BlockWorker/EE-BlockBox-v2/Screen/screenBase.png

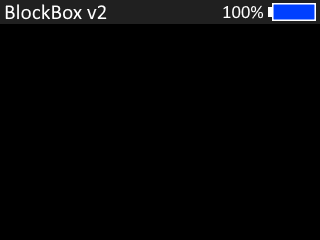
Screen/screenBase.png
