BlockWorker/EE-BlockBox-v2/Screen/screenPowerButton.png

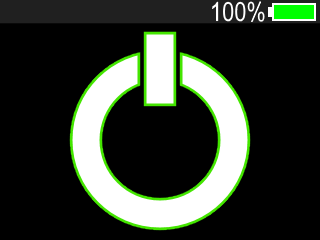
Screen/screenPowerButton.png
