BlockWorker/EE-BlockBox-v2/(list of files, cad)

Other CAD files:
Fusion360/Main v23.f3z
