BlockWorker/EE-BlockBox-v2/BlockBox v2.brd

## EAGLE design BlockBox v2.brd (2020-03-26)

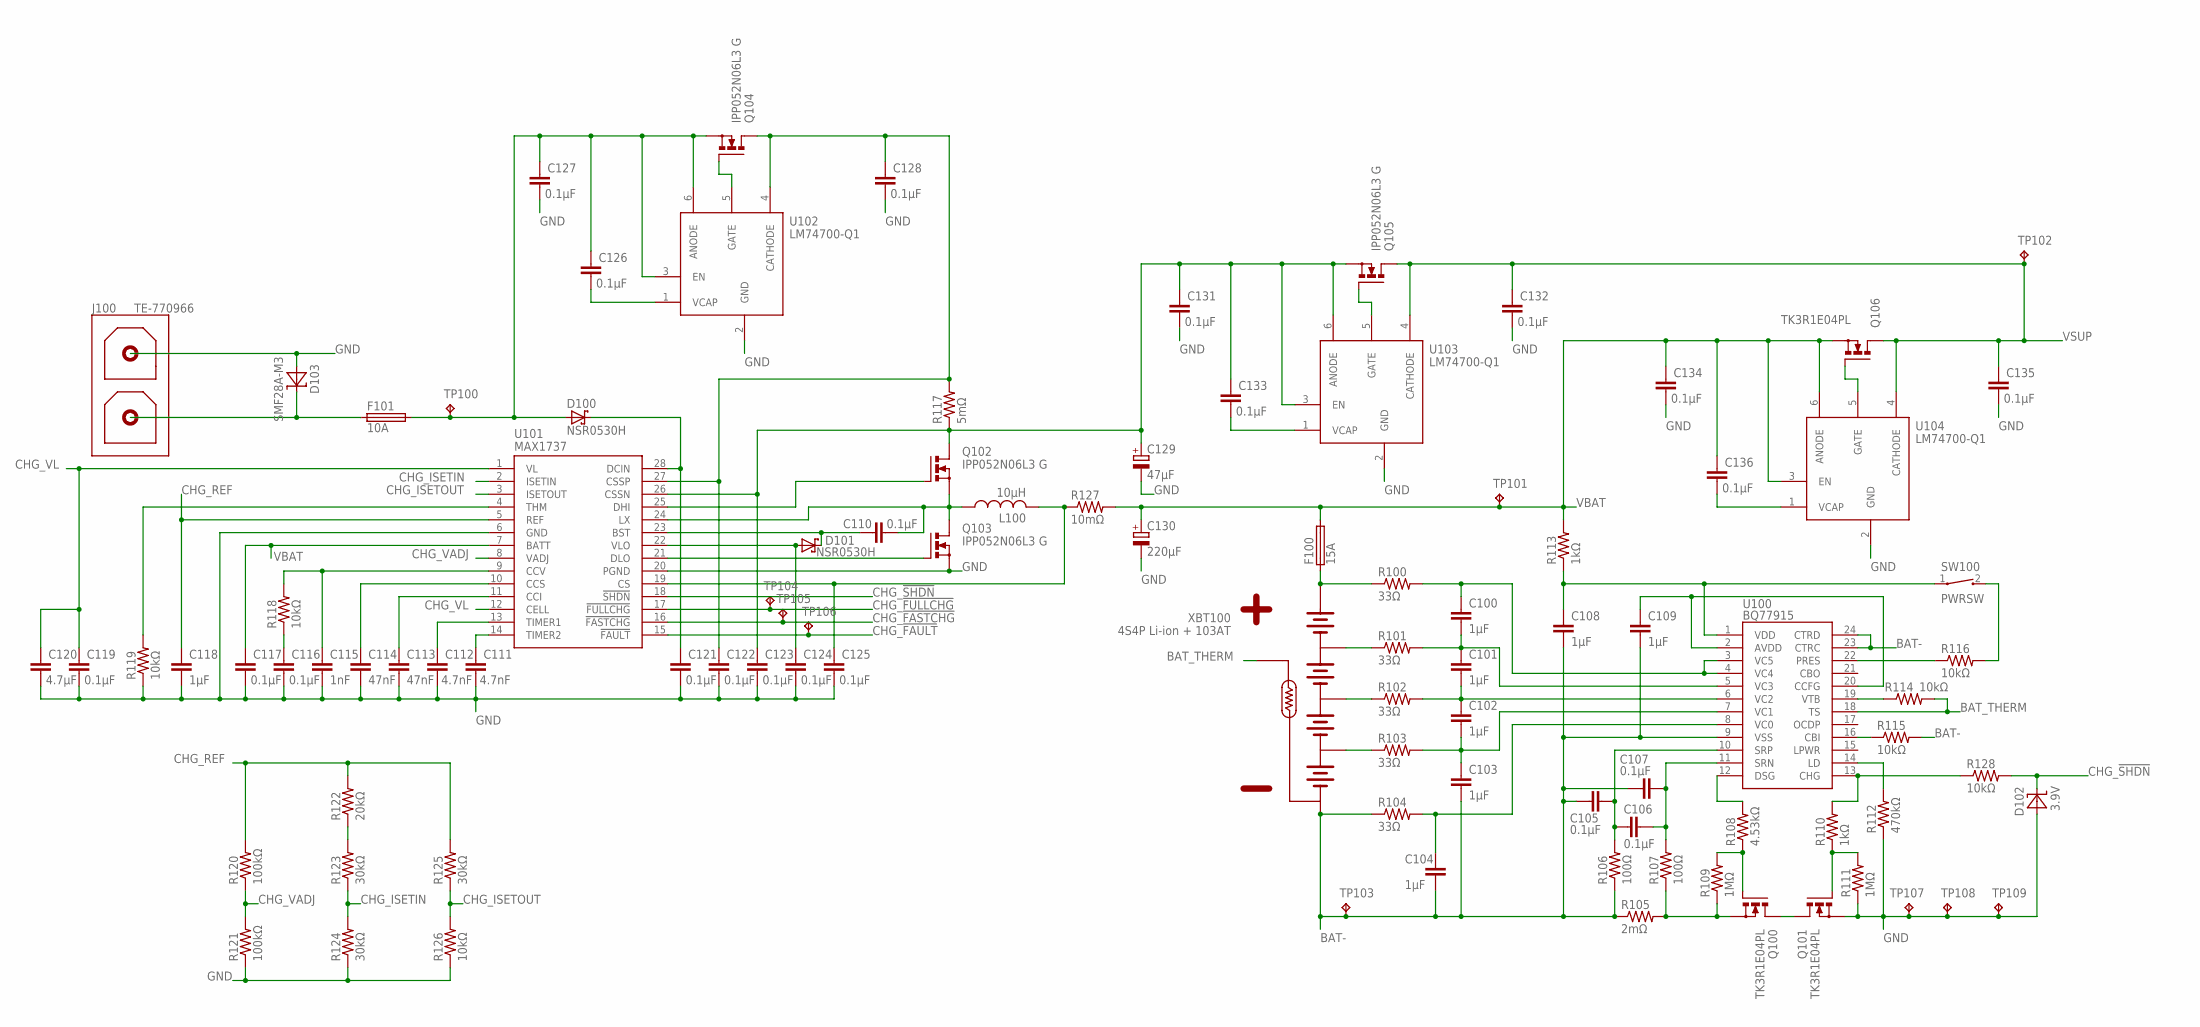
[picture p3: schematic BlockBox v2.sch, sheet 1, Battery]

Parts:
C100, C101, C102, C103, C104, C108, C109, C118: 1µF; C0603
C105, C106, C107, C110, C116, C117, C119, C121, C122, C123, C124, C125, C126, C127, C128, C131, C132, C133, C134, C135, C136: 0.1µF; C0603
C111, C112: 4.7nF; C0603
C113, C114: 47nF; C0603
C115: 1nF; C0603
C120: 4.7µF; C0805
C129: 47µF; E2,5-6
C130: 220µF; E3,5-8
D100, D101: NSR0530H; SOD323
D102: 3.9V; SOD323
D103: SMF28A-M3; DO-219AB
F100: 15A; F2410
F101: 10A; F2410
J100: TE-770966
L100: 10µH; PM5022
Q100, Q101, Q106: TK3R1E04PL; TO220BV-HS1
Q102, Q103, Q104, Q105: IPP052N06L3 G; TO220BV-HS1
R100, R101, R102, R103, R104: 33Ω; R0603
R105: 2mΩ; R2512
R106, R107: 100Ω; R0603
R108: 4.53kΩ; R0603
R109, R111: 1MΩ; R0603
R110, R113: 1kΩ; R0603
R112: 470kΩ; R0603
R114, R115, R116, R118, R119, R126, R128: 10kΩ; R0603
R117: 5mΩ; R1206
R120, R121: 100kΩ; R0603
R122: 20kΩ; R0603
R123, R124, R125: 30kΩ; R0603
R127: 10mΩ; R1206
SW100: PWRSW; WIRE-2P-SIMPLE
TP100, TP101, TP102, TP103, TP104, TP105, TP106, TP107, TP108, TP109: TPTP15R; TP15R
U100: BQ77915; TSSOP24
U101: MAX1737; QSOP28
U102, U103, U104: LM74700-Q1; SOT23-6L
XBT100: 4S4P Li-ion + 103AT; TE-770970

Connections:
BAT-: C103.2, C104.2, C105.1, C107.1, C108.2, C109.2, R104.1, R105.1, R106.1, R115.2, TP103.TP, U100.9 (VSS), U100.23 (CTRC), U100.24 (CTRD), XBT100.5 (-), XBT100.6 (-); also elsewhere on the board
BAT-_INT1: Q100.S, R105.2, R107.1, R109.1
BAT-_INT2: Q100.D, Q101.D
BAT_AVDD: C109.1, U100.2 (AVDD), U100.20 (CCFG)
BAT_BAL0: C104.1, R104.2, U100.8 (VC0)
BAT_BAL1: C102.2, C103.1, R103.2, U100.7 (VC1)
BAT_BAL2: C101.2, C102.1, R102.2, U100.6 (VC2)
BAT_BAL3: C100.2, C101.1, R101.2, U100.5 (VC3)
BAT_BAL4: C100.1, R100.2, U100.3 (VC5), U100.4 (VC4)
BAT_CBI: R115.1, U100.16 (CBI)
BAT_CHG_CTL: R110.2, R128.1, U100.13 (CHG)
BAT_CHG_GATE: Q101.G, R110.1, R111.2
BAT_CSN: C106.2, C107.2, R107.2, U100.11 (SRN); also elsewhere on the board
BAT_CSP: C105.2, C106.1, R106.2, U100.10 (SRP); also elsewhere on the board
BAT_DSG_CTL: R108.2, U100.12 (DSG)
BAT_DSG_GATE: Q100.G, R108.1, R109.2
BAT_INT1: R103.1, XBT100.4 (BAL1)
BAT_INT2: R102.1, XBT100.3 (BAL2)
BAT_INT3: R101.1, XBT100.7 (BAL3)
BAT_LD: R112.2, U100.14 (LD)
BAT_PRES: R116.1, U100.22 (PRES)
BAT_PRES_SW: R116.2, SW100.2
BAT_THERM: R114.2, U100.18 (TS), XBT100.8 (THERM1)
BAT_VDD: C108.1, R113.1, SW100.1, U100.1 (VDD)
BAT_VTB: R114.1, U100.19 (VTB)
CHG_!FASTCHG: TP105.TP, U101.16 (!FASTCHG); also elsewhere on the board
CHG_!FAULT: TP106.TP, U101.15 (!FAULT); also elsewhere on the board
CHG_!FULLCHG: TP104.TP, U101.17 (!FULLCHG); also elsewhere on the board
CHG_!SHDN: D102.1 (C), R128.2, U101.18 (!SHDN)
CHG_BST: C110.1, D101.1 (C), U101.23 (BST)
CHG_CCI: C113.1, U101.11 (CCI)
CHG_CCS: C114.1, U101.10 (CCS)
CHG_CCV: C115.1, R118.2, U101.9 (CCV)
CHG_CCV_FILT: C116.1, R118.1
CHG_CS: C125.1, L100.2, R127.1, U101.19 (CS)
CHG_CSSN: C123.1, C129.+, C131.1, C133.1, Q102.D, Q105.S, R117.1, U101.26 (CSSN), U103.3 (EN), U103.6 (ANODE)
CHG_CSSP: C122.1, C128.1, Q104.D, R117.2, U101.27 (CSSP), U102.4 (CATHODE)
CHG_DCIN: C121.1, D100.1 (C), U101.28 (DCIN)
CHG_DHI: Q102.G, U101.25 (DHI)
CHG_DLO: Q103.G, U101.21 (DLO)
CHG_ISETIN: R123.1, R124.2, U101.2 (ISETIN)
CHG_ISETIN_INT: R122.1, R123.2
CHG_ISETOUT: R125.1, R126.2, U101.3 (ISETOUT)
CHG_LX: C110.2, L100.1, Q102.S, Q103.D, U101.24 (LX)
CHG_REF: C118.1, R120.2, R122.2, R125.2, U101.5 (REF)
CHG_THM: R119.2, U101.4 (THM)
CHG_TIMER1: C112.1, U101.13 (TIMER1)
CHG_TIMER2: C111.1, U101.14 (TIMER2)
CHG_VADJ: R120.1, R121.2, U101.8 (VADJ)
CHG_VL: C119.1, C120.1, U101.1 (VL), U101.12 (CELL)
CHG_VLO: C124.1, D101.2 (A), U101.22 (VLO)
GND: C111.2, C112.2, C113.2, C114.2, C115.2, C116.2, C117.2, C118.2, C119.2, C120.2, C121.2, C122.2, C123.2, C124.2, C125.2, C127.2, C128.2, C129.-, C130.-, C131.2, C132.2, C134.2, C135.2, D102.2 (A), D103.A, J100.2, Q101.S, Q103.S, R111.1, R112.1, R119.1, R121.1, R124.1, R126.1, TP107.TP, TP108.TP, TP109.TP, U101.6 (GND), U101.20 (PGND), U102.2 (GND), U103.2 (GND), U104.2 (GND); also elsewhere on the board
VBAT: C117.1, C130.+, C134.1, C136.1, F100.2, Q106.S, R113.2, R127.2, TP101.TP, U101.7 (BATT), U104.3 (EN), U104.6 (ANODE); also elsewhere on the board
VBAT_PREFUSE: F100.1, R100.1, XBT100.1 (+), XBT100.2 (+)
VIN_EXT: D103.K (C), F101.1, J100.1
VIN_EXT_FUSED: C126.1, C127.1, D100.2 (A), F101.2, Q104.S, TP100.TP, U102.3 (EN), U102.6 (ANODE)
VIN_ID_GATE: Q104.G, U102.5 (GATE)
VIN_ID_VCAP: C126.2, U102.1 (VCAP)
VSUP: C132.1, C135.1, Q105.D, Q106.D, TP102.TP, U103.4 (CATHODE), U104.4 (CATHODE); also elsewhere on the board
VSUP_ID1_GATE: Q105.G, U103.5 (GATE)
VSUP_ID1_VCAP: C133.2, U103.1 (VCAP)
VSUP_ID2_GATE: Q106.G, U104.5 (GATE)
VSUP_ID2_VCAP: C136.2, U104.1 (VCAP)

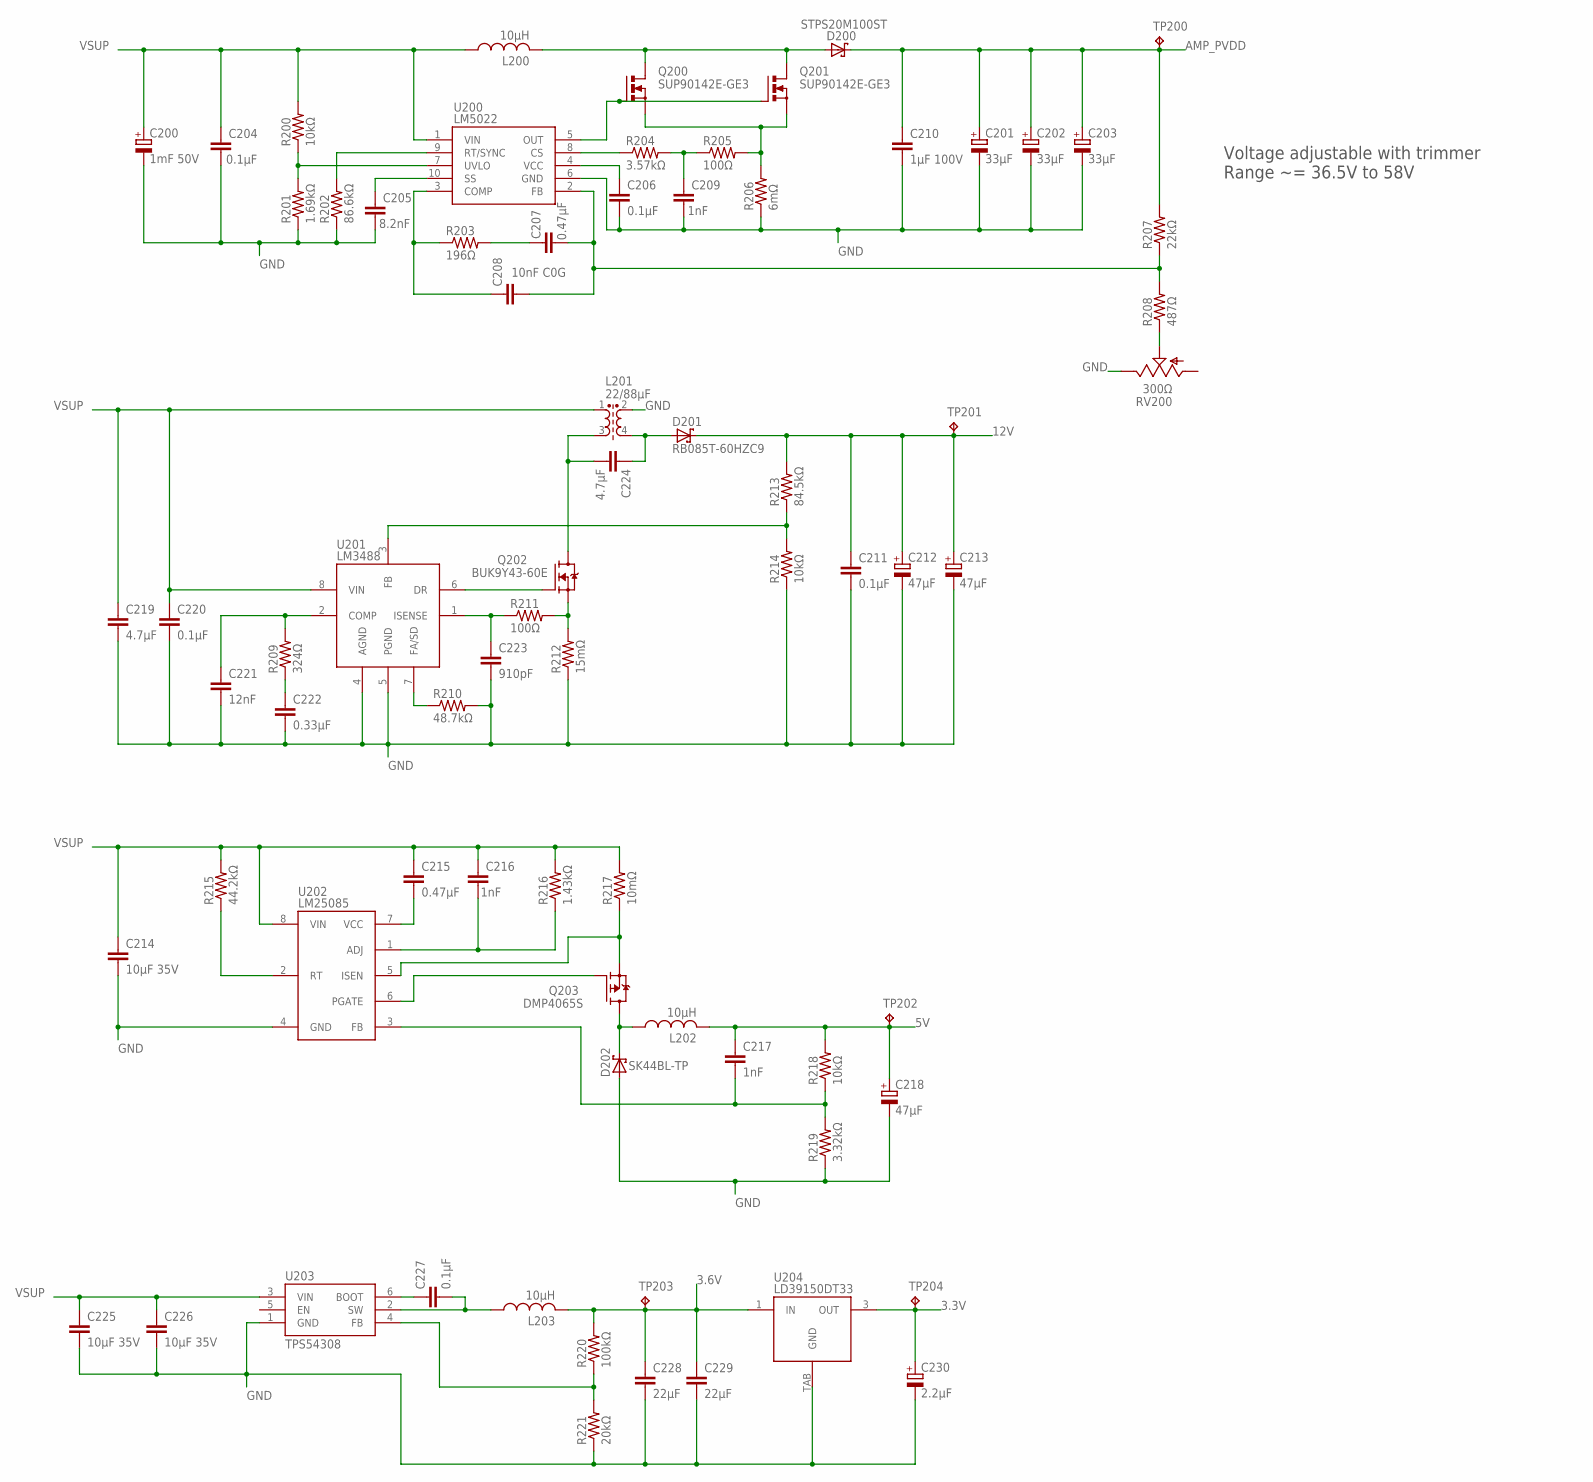
[picture p4: schematic BlockBox v2.sch, sheet 2, Power conversion]

Parts:
C200: 1mF 50V; E7,5-16
C201, C202, C203: 33µF; E3,5-8
C204, C206, C211, C220, C227: 0.1µF; C0603
C205: 8.2nF; C0603
C207: 0.47µF; C050-035X075
C208: 10nF C0G; C0603
C209, C216, C217: 1nF; C0603
C210: 1µF 100V; C1206
C212, C213, C218: 47µF; E2,5-6
C214, C225, C226: 10µF 35V; C1206
C215: 0.47µF; C0603
C219, C224: 4.7µF; C0805
C221: 12nF; C0603
C222: 0.33µF; C050-035X075
C223: 910pF; C0603
C228, C229: 22µF; C0805
C230: 2.2µF; PANASONIC_B
D200: STPS20M100ST; TO220ABS-HS1
D201: RB085T-60HZC9; TO220ABS-HS1
D202: SK44BL-TP; DO-214AA
L200: 10µH; PQ2614B
L201: 22/88µF; SRF1280A
L202: 10µH; SRN1060
L203: 10µH; RLB0912
Q200, Q201: SUP90142E-GE3; TO220BV-HS1
Q202: BUK9Y43-60E; SOT669
Q203: DMP4065S; SOT23
R200, R214, R218: 10kΩ; R0603
R201: 1.69kΩ; R0603
R202: 86.6kΩ; R0603
R203: 196Ω; R0603
R204: 3.57kΩ; R0603
R205, R211: 100Ω; R0603
R206: 6mΩ; R2512
R207: 22kΩ; R0603
R208: 487Ω; R0603
R209: 324Ω; R0603
R210: 48.7kΩ; R0603
R212: 15mΩ; R0612
R213: 84.5kΩ; R0603
R215: 44.2kΩ; R0603
R216: 1.43kΩ; R0603
R217: 10mΩ; R1206
R219: 3.32kΩ; R0603
R220: 100kΩ; R0603
R221: 20kΩ; R0603
RV200: 300Ω; TC33X-2
TP200, TP201, TP202, TP203, TP204: TPTP15R; TP15R
U200: LM5022; VSSOP10
U201: LM3488; VSSOP8
U202: LM25085; VSSOP8
U203: TPS54308; SOT23-6L
U204: LD39150DT33; DPAK

Connections:
3.3V: C230.+, TP204.TP, U204.3 (OUT); also elsewhere on the board
3.6V: C228.1, C229.1, L203.2, R220.2, TP203.TP, U204.1 (IN)
5V: C217.1, C218.+, L202.2, R218.2, TP202.TP; also elsewhere on the board
12V: C211.1, C212.+, C213.+, D201.C, R213.2, TP201.TP; also elsewhere on the board
AMP_PVDD: C201.+, C202.+, C203.+, C210.1, D200.C, R207.2, TP200.TP; also elsewhere on the board
BOOST_COMP: C208.1, R203.1, U200.3 (COMP)
BOOST_COMP_INT: C207.1, R203.2
BOOST_CS: R204.1, U200.8 (CS)
BOOST_CS_FILTER: C209.1, R204.2, R205.1
BOOST_FB: C207.2, C208.2, R207.1, R208.2, U200.2 (FB)
BOOST_FB_ADJ: R208.1, RV200.2 (S)
BOOST_RT: R202.2, U200.9 (RT/SYNC)
BOOST_SS: C205.1, U200.10 (SS)
BOOST_SW_DRAIN: D200.A1 (A), D200.A2 (A), L200.2, Q200.D, Q201.D
BOOST_SW_GATE: Q200.G, Q201.G, U200.5 (OUT)
BOOST_SW_SOURCE: Q200.S, Q201.S, R205.2, R206.2
BOOST_UVLO: R200.1, R201.2, U200.7 (UVLO)
BOOST_VCC: C206.1, U200.4 (VCC)
BUCK_ADJ: C216.2, R216.1, U202.1 (ADJ)
BUCK_FB: C217.2, R218.1, R219.2, U202.3 (FB)
BUCK_RT: R215.1, U202.2 (RT)
BUCK_SW_DRAIN: Q203.2 (S), R217.1, U202.5 (ISEN)
BUCK_SW_GATE: Q203.1 (G), U202.6 (PGATE)
BUCK_SW_SOURCE: D202.K (C), L202.1, Q203.3 (D)
BUCK_VCC: C215.2, U202.7 (VCC)
GND: C200.-, C201.-, C202.-, C203.-, C204.2, C205.2, C206.2, C209.2, C210.2, C211.2, C212.-, C213.-, C214.2, C218.-, C219.2, C220.2, C221.2, C222.2, C223.2, C225.2, C226.2, C228.2, C229.2, C230.-, D202.A, L201.2 (S1), R201.1, R202.1, R206.1, R210.2, R212.1, R214.1, R219.1, R221.1, RV200.3 (E), U200.6 (GND), U201.4 (AGND), U201.5 (PGND), U202.4 (GND), U203.1 (GND), U204.TAB (GND); also elsewhere on the board
PRELIN_BOOT: C227.1, U203.6 (BOOT)
PRELIN_FB: R220.1, R221.2, U203.4 (FB)
PRELIN_SW: C227.2, L203.1, U203.2 (SW)
SEPIC_COMP: C221.1, R209.2, U201.2 (COMP)
SEPIC_COMP_INT: C222.1, R209.1
SEPIC_FA: R210.1, U201.7 (FA/SD)
SEPIC_FB: R213.1, R214.2, U201.3 (FB)
SEPIC_ISENSE: C223.1, R211.1, U201.1 (ISENSE)
SEPIC_PREDIODE: C224.1, D201.A1 (A), D201.A2 (A), L201.4 (S2)
SEPIC_SW_DRAIN: C224.2, L201.3 (P2), Q202.MB (D)
SEPIC_SW_GATE: Q202.4 (G), U201.6 (DR)
SEPIC_SW_SOURCE: Q202.1 (S), Q202.2 (S), Q202.3 (S), R211.2, R212.2
VSUP: C200.+, C204.1, C214.1, C215.1, C216.1, C219.1, C220.1, C225.1, C226.1, L200.1, L201.1, R200.2, R215.2, R216.2, R217.2, U200.1 (VIN), U201.8 (VIN), U202.8 (VIN), U203.3 (VIN); also elsewhere on the board

Notes on the sheet:
Voltage adjustable with trimmer Range ~= 36.5V to 58V

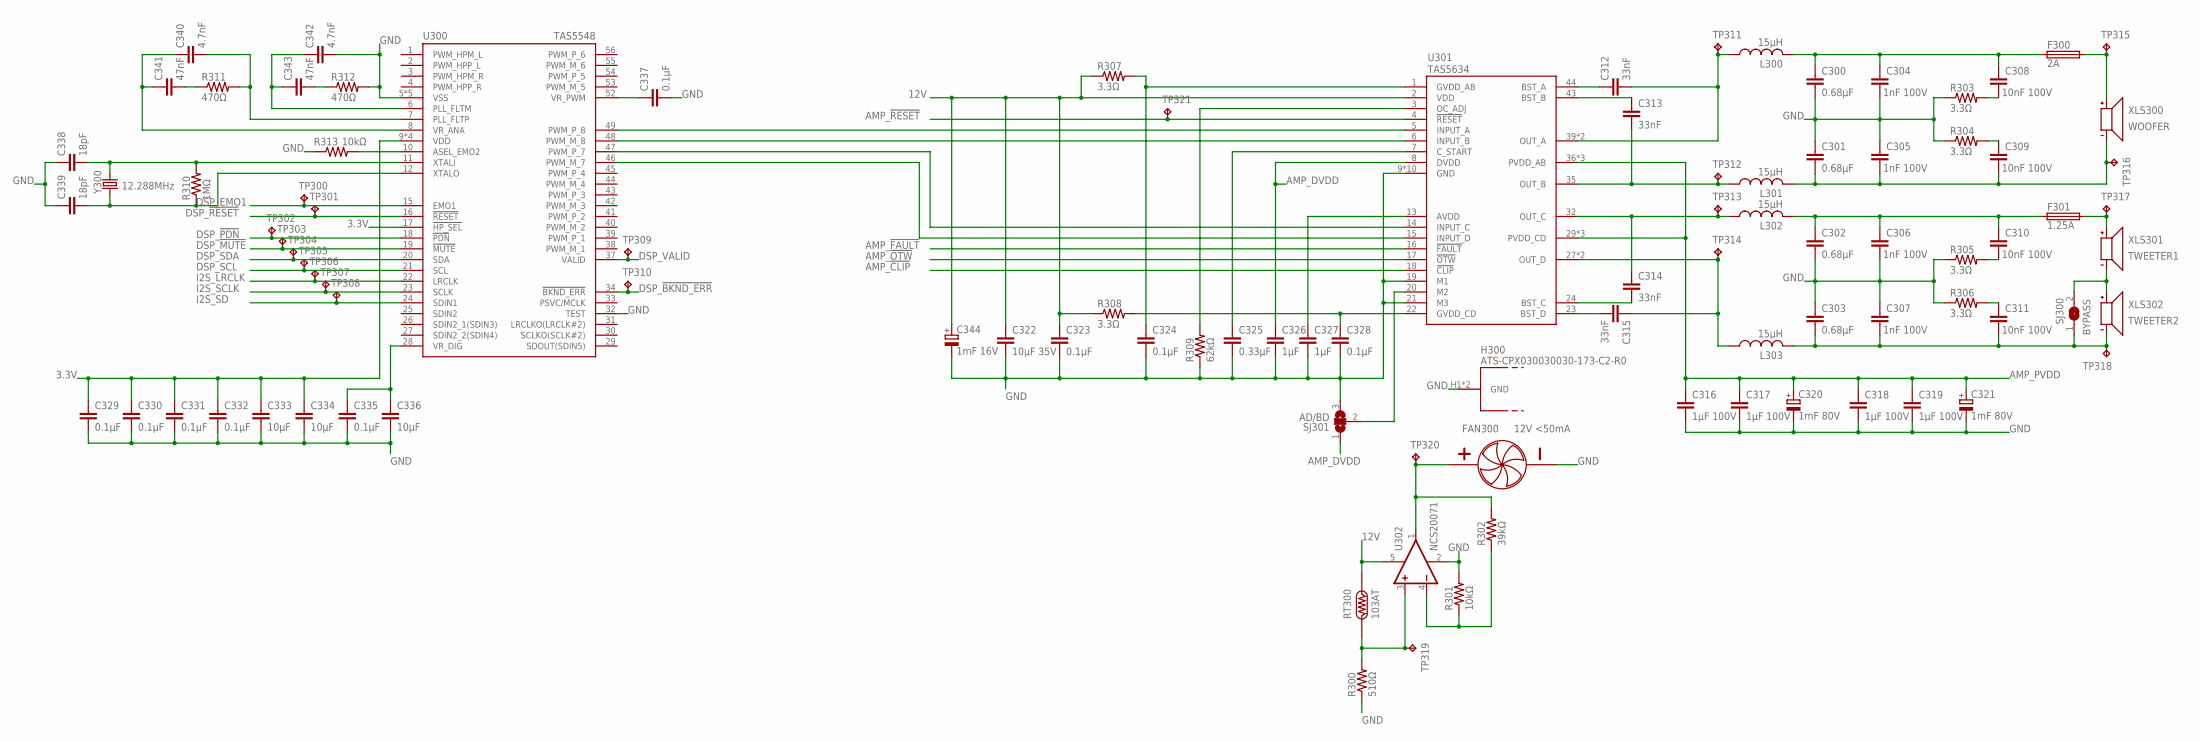
[picture p5: schematic BlockBox v2.sch, sheet 3, Audio path]

Parts:
C300, C301, C302, C303: 0.68µF; C150-064X183
C304, C305, C306, C307: 1nF 100V; C0603
C308, C309, C310, C311: 10nF 100V; C0603
C312, C313, C314, C315: 33nF; C0805
C316, C317, C318, C319: 1µF 100V; C1206
C320, C321: 1mF 80V; E7,5-16
C322: 10µF 35V; C1206
C323, C324, C328, C329, C330, C331, C332, C335, C337: 0.1µF; C0603
C325: 0.33µF; C0603
C326, C327: 1µF; C0603
C333, C334, C336: 10µF; C0805
C338, C339: 18pF; C0603
C340, C342: 4.7nF; C0603
C341, C343: 47nF; C0603
C344: 1mF 16V; E5-10,5
F300: 2A; MRF_FUSE
F301: 1.25A; MRF_FUSE
FAN300: 12V <50mA; WIRE-2P-SIMPLE
H300: ATS-CPX030030030-173-C2-R0
L300, L301, L302, L303: 15µH; 1D14A
R300: 510Ω; R0603
R301, R313: 10kΩ; R0603
R302: 39kΩ; R0603
R303, R304, R305, R306, R307, R308: 3.3Ω; R0805
R309: 62kΩ; R0603
R310: 1MΩ; R0603
R311, R312: 470Ω; R0603
RT300: 103AT; WIRE-2P-SIMPLE
SJ300: BYPASS; SJ
SJ301: AD/BD; SJ_2
TP300, TP301, TP302, TP303, TP304, TP305, TP306, TP307, TP308, TP309, TP310, TP311, TP312, TP313, TP314, TP315, TP316, TP317, TP318, TP319, TP320, TP321: TPTP15R; TP15R
U300: TAS5548; HTSSOP56DCA
U301: TAS5634; TSSOP44
U302: NCS20071; TSOP-5
XLS300: WOOFER; TE-770966
XLS301: TWEETER1; TE-770966
XLS302: TWEETER2; TE-770966
Y300: 12.288MHz; HC49US

Connections:
3.3V: C329.1, C330.1, C331.1, C332.1, C333.1, C334.1, U300.9 (VDD), U300.14 (VDD), U300.17 (!HP_SEL), U300.35 (VDD), U300.50 (VDD); also elsewhere on the board
12V: C322.1, C323.1, C344.+, R307.1, R308.1, RT300.1, U301.2 (VDD), U302.5 (V+); also elsewhere on the board
AMP_!CLIP: U301.18 (!CLIP); also elsewhere on the board
AMP_!FAULT: U301.16 (!FAULT); also elsewhere on the board
AMP_!OTW: U301.17 (!OTW); also elsewhere on the board
AMP_!RESET: TP321.TP, U301.4 (!RESET); also elsewhere on the board
AMP_AVDD: C327.1, U301.13 (AVDD)
AMP_A_FILT: C300.1, C304.1, C308.1, F300.1, L300.2
AMP_A_FILT_INT: C308.2, R303.2
AMP_A_FUSED: F300.2, TP315.TP, XLS300.2 (+)
AMP_BST_A: C312.1, U301.44 (BST_A)
AMP_BST_B: C313.1, U301.43 (BST_B)
AMP_BST_C: C314.2, U301.24 (BST_C)
AMP_BST_D: C315.2, U301.23 (BST_D)
AMP_B_FILT: C301.1, C305.2, C309.2, L301.2, TP316.TP, XLS300.1 (-)
AMP_B_FILT_INT: C309.1, R304.2
AMP_CD_MID: SJ300.2, XLS301.1 (-), XLS302.2 (+)
AMP_C_FILT: C302.1, C306.1, C310.1, F301.1, L302.2
AMP_C_FILT_INT: C310.2, R305.2
AMP_C_FUSED: F301.2, TP317.TP, XLS301.2 (+)
AMP_C_START: C325.1, U301.7 (C_START)
AMP_DVDD: C326.1, SJ301.1, U301.8 (DVDD)
AMP_D_FILT: C303.1, C307.2, C311.2, L303.2, SJ300.1, TP318.TP, XLS302.1 (-)
AMP_D_FILT_INT: C311.1, R306.2
AMP_FAN_+: FAN300.1 (+), R302.2, TP320.TP, U302.1 (OUT)
AMP_FAN_FB: R301.1, R302.1, U302.4 (-IN)
AMP_FAN_SENSE: R300.2, RT300.2, TP319.TP, U302.3 (+IN)
AMP_GVDD_AB: C324.1, R307.2, U301.1 (GVDD_AB)
AMP_GVDD_CD: C328.1, R308.2, U301.22 (GVDD_CD)
AMP_INPUT_A: U300.49 (PWM_P_8), U301.5 (INPUT_A)
AMP_INPUT_B: U300.48 (PWM_M_8), U301.6 (INPUT_B)
AMP_INPUT_C: U300.47 (PWM_P_7), U301.14 (INPUT_C)
AMP_INPUT_D: U300.46 (PWM_M_7), U301.15 (INPUT_D)
AMP_M2: SJ301.2, U301.20 (M2)
AMP_OC_ADJ: R309.2, U301.3 (OC_ADJ)
AMP_OUT_A: C312.2, L300.1, TP311.TP, U301.39 (OUT_A), U301.40 (OUT_A)
AMP_OUT_B: C313.2, L301.1, TP312.TP, U301.35 (OUT_B)
AMP_OUT_C: C314.1, L302.1, TP313.TP, U301.32 (OUT_C)
AMP_OUT_D: C315.1, L303.1, TP314.TP, U301.27 (OUT_D), U301.28 (OUT_D)
AMP_PVDD: C316.1, C317.1, C318.1, C319.1, C320.+, C321.+, U301.29 (PVDD_CD), U301.30 (PVDD_CD), U301.31 (PVDD_CD), U301.36 (PVDD_AB), U301.37 (PVDD_AB), U301.38 (PVDD_AB); also elsewhere on the board
DSP_!BKND_ERR: TP310.TP, U300.34 (!BKND_ERR); also elsewhere on the board
DSP_!MUTE: TP303.TP, U300.19 (!MUTE); also elsewhere on the board
DSP_!PDN: TP302.TP, U300.18 (!PDN); also elsewhere on the board
DSP_!RESET: TP301.TP, U300.16 (!RESET); also elsewhere on the board
DSP_ASEL_EMO2: R313.2, U300.10 (ASEL_EMO2)
DSP_EMO1: TP300.TP, U300.15 (EMO1); also elsewhere on the board
DSP_PLL_FLTM: C342.1, C343.1, U300.6 (PLL_FLTM)
DSP_PLL_FLTP: C340.2, R311.2, U300.7 (PLL_FLTP)
DSP_PLL_FLTP_INT: C341.2, R311.1
DSP_PLL_FPLM_INT: C343.2, R312.1
DSP_SCL: TP305.TP, U300.21 (SCL); also elsewhere on the board
DSP_SDA: TP304.TP, U300.20 (SDA); also elsewhere on the board
DSP_VALID: TP309.TP, U300.37 (VALID); also elsewhere on the board
DSP_VR_ANA: C340.1, C341.1, U300.8 (VR_ANA)
DSP_VR_DIG: C335.1, C336.1, U300.28 (VR_DIG)
DSP_VR_PWM: C337.1, U300.52 (VR_PWM)
DSP_XTALI: C338.2, R310.2, U300.11 (XTALI), Y300.2
DSP_XTALO: C339.2, R310.1, U300.12 (XTALO), Y300.1
GND: C300.2, C301.2, C302.2, C303.2, C304.2, C305.1, C306.2, C307.1, C316.2, C317.2, C318.2, C319.2, C320.-, C321.-, C322.2, C323.2, C324.2, C325.2, C326.2, C327.2, C328.2, C329.2, C330.2, C331.2, C332.2, C333.2, C334.2, C335.2, C336.2, C337.2, C338.1, C339.1, C342.2, C344.-, FAN300.2 (-), H300.H1, H300.H2, R300.1, R301.2, R303.1, R304.1, R305.1, R306.1, R309.1, R312.2, R313.1, SJ301.3, U300.5 (VSS), U300.13 (VSS), U300.32 (TEST), U300.36 (VSS), U300.51 (VSS), U300.EXP (VSS), U301.9 (GND), U301.10 (GND), U301.11 (GND), U301.12 (GND), U301.19 (M1), U301.21 (M3), U301.25 (GND), U301.26 (GND), U301.33 (GND), U301.34 (GND), U301.41 (GND), U301.42 (GND), U302.2 (V-); also elsewhere on the board
I2S_LRCLK: TP306.TP, U300.22 (LRCLK); also elsewhere on the board
I2S_SCLK: TP307.TP, U300.23 (SCLK); also elsewhere on the board
I2S_SD: TP308.TP, U300.24 (SDIN1); also elsewhere on the board

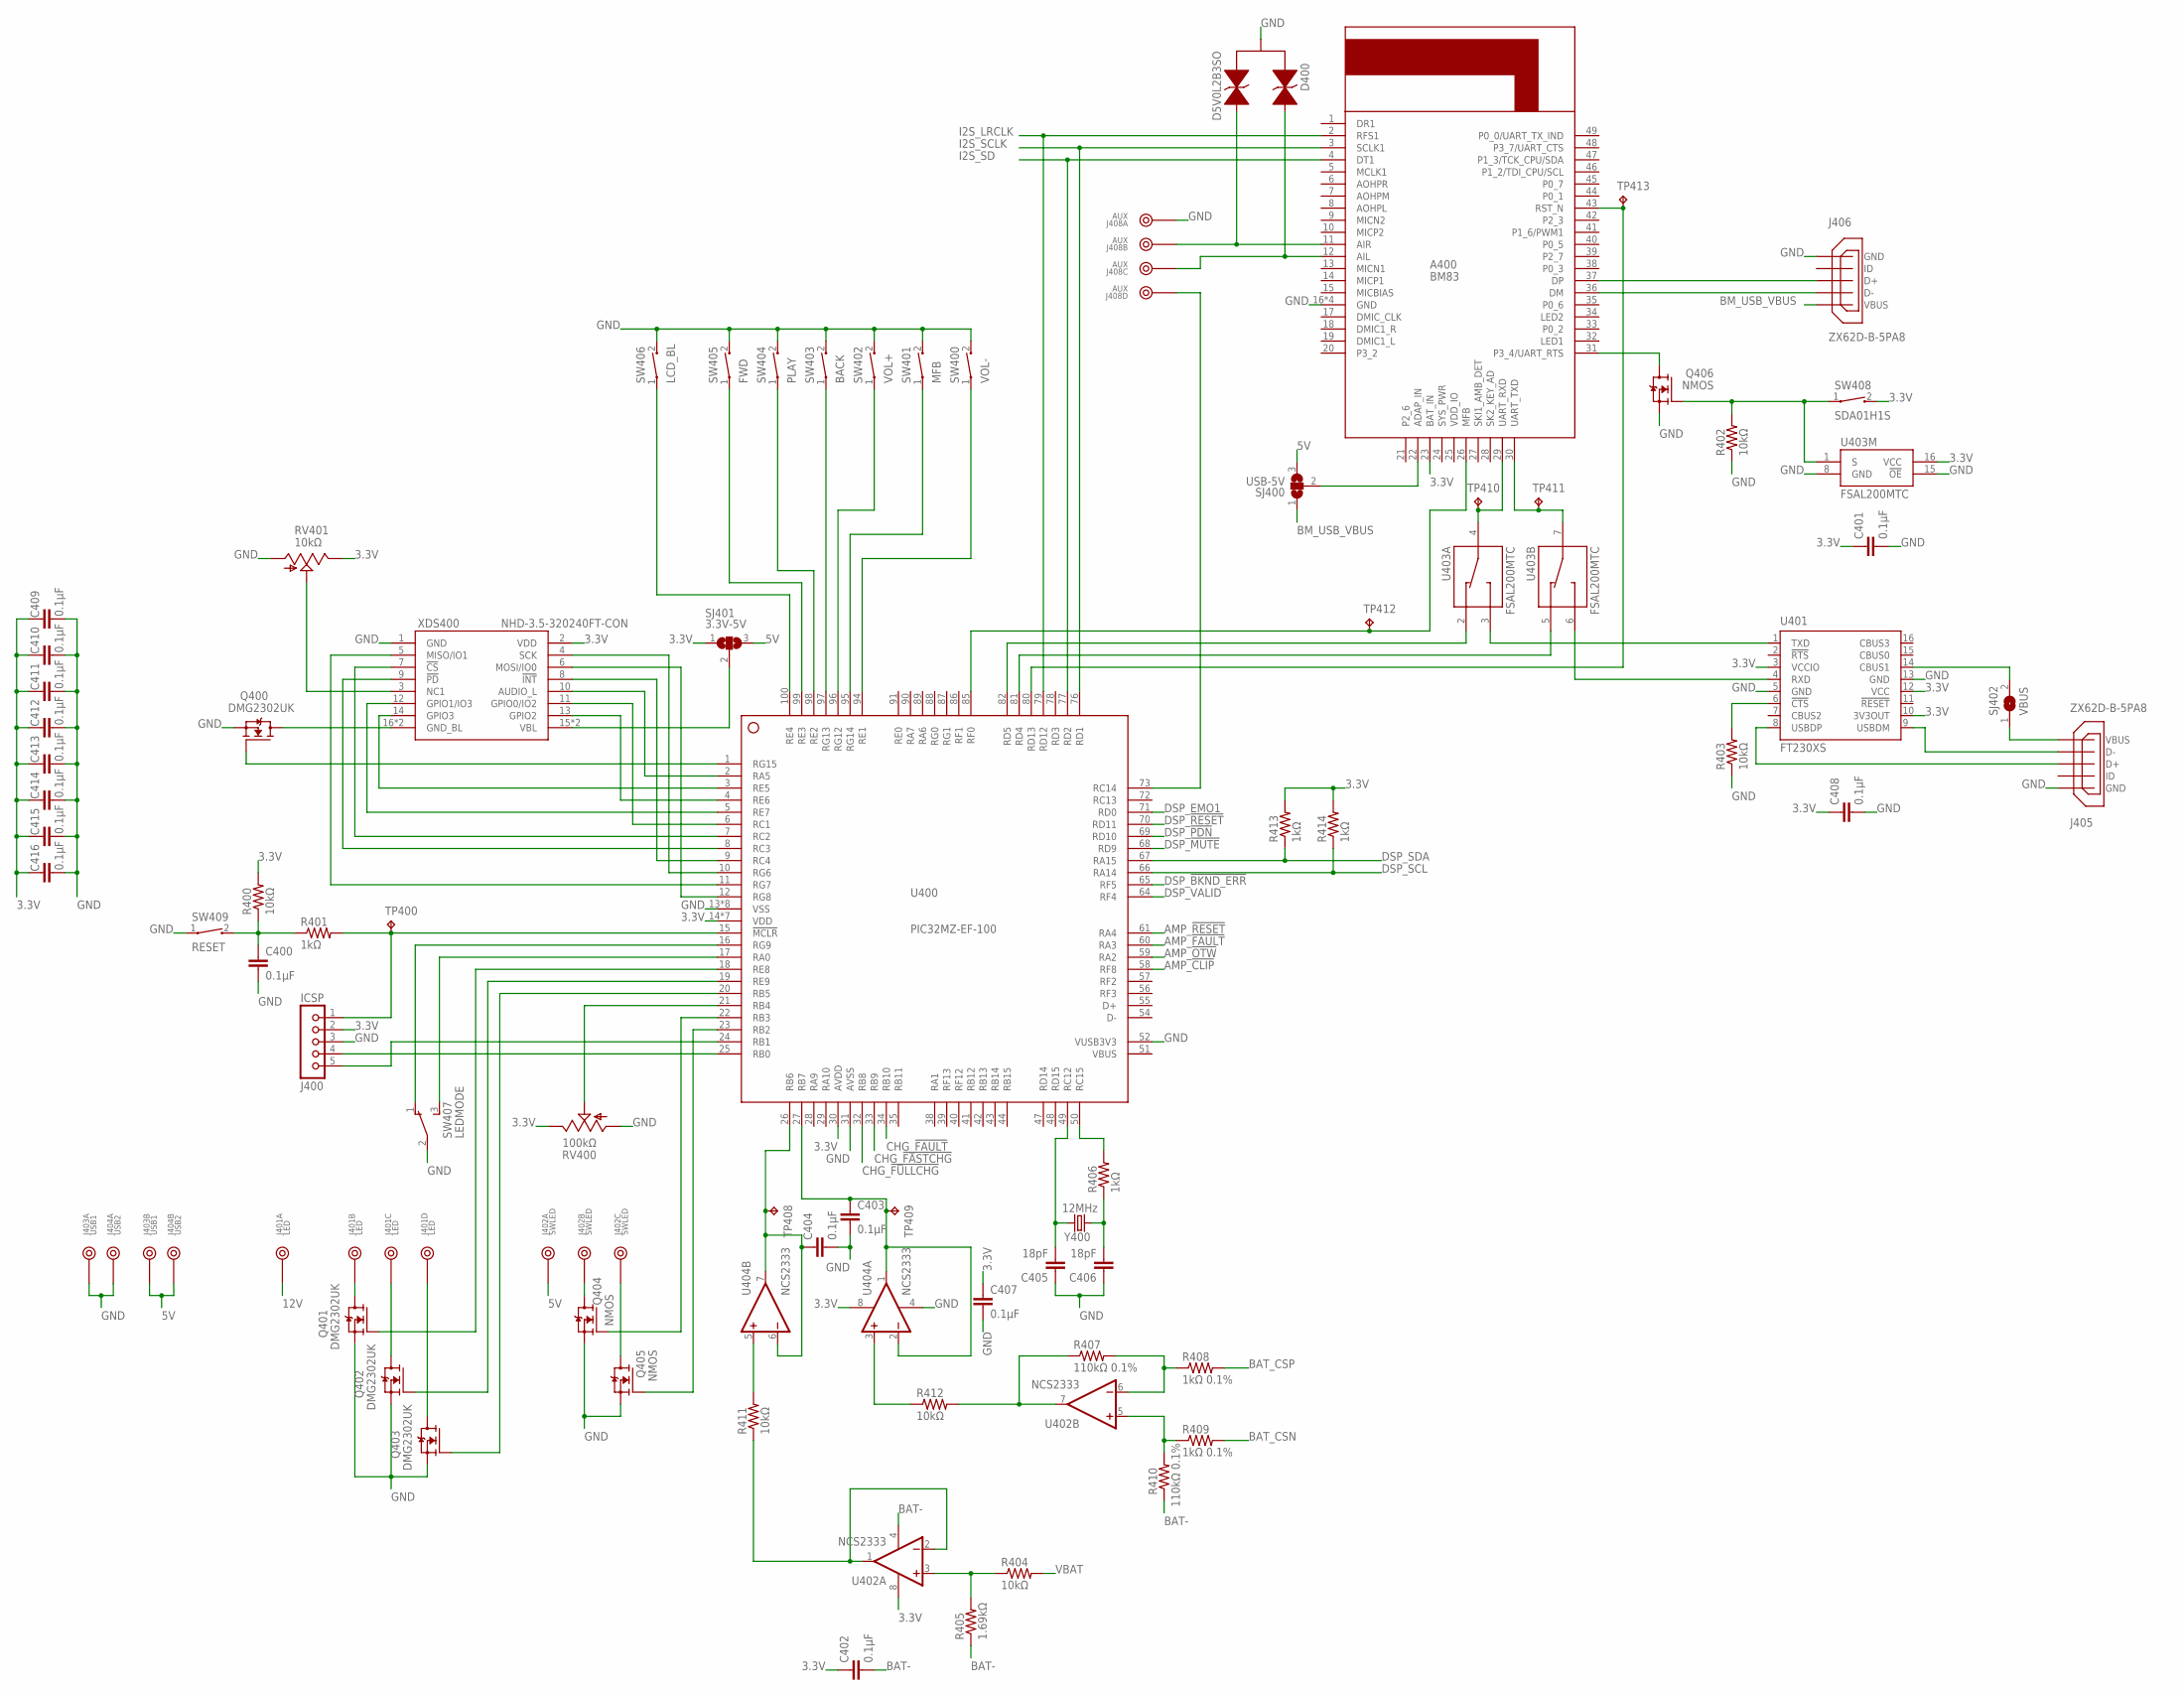
[picture p6: schematic BlockBox v2.sch, sheet 4, Control]

Parts:
A400: BM83
C400, C401, C402, C403, C404, C407, C408, C409, C410, C411, C412, C413, C414, C415, C416: 0.1µF; C0603
C405, C406: 18pF; C0603
D400: D5V0L2B3SO; SOT23
J400: ICSP; 5P-1.27-POGO
J401: LED; 4PIN
J402: SWLED; 3PIN
J403: USB1; 2PIN
J404: USB2; 2PIN
J405, J406: ZX62D-B-5PA8
J408: AUX; 4PIN
Q400, Q401, Q402, Q403: DMG2302UK; SOT23
Q404, Q405, Q406: NMOS; SOT23
R400, R402, R403, R404, R411, R412: 10kΩ; R0603
R401, R406, R413, R414: 1kΩ; R0603
R405: 1.69kΩ; R0603
R407, R410: 110kΩ 0.1%; R0603
R408, R409: 1kΩ 0.1%; R0603
RV400: 100kΩ; WIRE-3P-SIMPLE
RV401: 10kΩ; TC33X-2
SJ400: USB-5V; SJ_2
SJ401: 3.3V-5V; SJ_2
SJ402: VBUS; SJ
SW400: VOL-; WIRE-2P-SIMPLE
SW401: MFB; WIRE-2P-SIMPLE
SW402: VOL+; WIRE-2P-SIMPLE
SW403: BACK; WIRE-2P-SIMPLE
SW404: PLAY; WIRE-2P-SIMPLE
SW405: FWD; WIRE-2P-SIMPLE
SW406: LCD_BL; WIRE-2P-SIMPLE
SW407: LEDMODE; WIRE-3P-SIMPLE
SW408: SDA01H1S
SW409: RESET; WIRE-2P-SIMPLE
TP400, TP408, TP409, TP410, TP411, TP412, TP413: TPTP15R; TP15R
U400: PIC32MZ-EF-100; TQFP100-14X14X1MM
U401: FT230XS; SSOP16
U402, U404: NCS2333; MSOP8
U403: FSAL200MTC; TSSOP16L
XDS400: NHD-3.5-320240FT-CON; 2X9PIN
Y400: 12MHz; HC49US

Connections:
3.3V: A400.23 (BAT_IN), C401.1, C402.1, C407.1, C408.1, C409.1, C410.1, C411.1, C412.1, C413.1, C414.1, C415.1, C416.1, J400.2, R400.2, R413.2, R414.2, RV400.3 (E), RV401.3 (E), SJ401.1, SW408.2, U400.14 (VDD), U400.30 (AVDD), U400.37 (VDD), U400.46 (VDD), U400.62 (VDD), U400.74 (VDD), U400.83 (VDD), U400.93 (VDD), U401.3 (VCCIO), U401.10 (3V3OUT), U401.12 (VCC), U402.8 (V+), U403.16 (VCC), U404.8 (V+), XDS400.2 (VDD); also elsewhere on the board
5V: J402.1, J403.2, J404.2, SJ400.3, SJ401.3; also elsewhere on the board
12V: J401.1; also elsewhere on the board
AMP_!CLIP: U400.58 (RF8); also elsewhere on the board
AMP_!FAULT: U400.60 (RA3); also elsewhere on the board
AMP_!OTW: U400.59 (RA2); also elsewhere on the board
AMP_!RESET: U400.61 (RA4); also elsewhere on the board
BAT-: C402.2, R405.1, R410.1, U402.4 (V-); also elsewhere on the board
BAT_CSN: R409.2; also elsewhere on the board
BAT_CSP: R408.2; also elsewhere on the board
BM_!RST: A400.43 (RST_N), TP413.TP, U400.80 (RD13)
BM_ADAP_IN: A400.22 (ADAP_IN), SJ400.2
BM_AUX_L: A400.12 (AIL), D400.1, J408.3
BM_AUX_R: A400.11 (AIR), D400.2, J408.2
BM_MFB: A400.26 (MFB), TP412.TP, U400.85 (RF0)
BM_P3_4: A400.31 (P3_4/UART_RTS), Q406.3 (D)
BM_UART_RXD: A400.29 (UART_RXD), TP410.TP, U403.4 (A)
BM_UART_SWITCH: Q406.1 (G), R402.2, SW408.1, U403.1 (S)
BM_UART_TXD: A400.30 (UART_TXD), TP411.TP, U403.7 (A)
BM_USB_D+: A400.37 (DP), J406.3 (D+)
BM_USB_D-: A400.36 (DM), J406.2 (D-)
BM_USB_VBUS: J406.1 (VBUS), SJ400.1
CHG_!FASTCHG: U400.33 (RB9); also elsewhere on the board
CHG_!FAULT: U400.34 (RB10); also elsewhere on the board
CHG_!FULLCHG: U400.32 (RB8); also elsewhere on the board
DSP_!BKND_ERR: U400.65 (RF5); also elsewhere on the board
DSP_!MUTE: U400.68 (RD9); also elsewhere on the board
DSP_!PDN: U400.69 (RD10); also elsewhere on the board
DSP_!RESET: U400.70 (RD11); also elsewhere on the board
DSP_EMO1: U400.71 (RD0); also elsewhere on the board
DSP_SCL: R414.1, U400.66 (RA14); also elsewhere on the board
DSP_SDA: R413.1, U400.67 (RA15); also elsewhere on the board
DSP_VALID: U400.64 (RF4); also elsewhere on the board
FT_!CTS: R403.2, U401.6 (!CTS)
FT_RXD: U401.4 (RXD), U403.6 (B2)
FT_TXD: U401.1 (TXD), U403.3 (B2)
FT_USB_D+: J405.3 (D+), U401.8 (USBDP)
FT_USB_D-: J405.2 (D-), U401.9 (USBDM)
FT_USB_VBUS: J405.1 (VBUS), SJ402.1
FT_VBUS_SENSE: SJ402.2, U401.14 (CBUS1)
GND: A400.16 (GND), A400.50 (GND), A400.G1 (GND), A400.G2 (GND), C400.2, C401.2, C403.2, C404.2, C405.1, C406.1, C407.2, C408.2, C409.2, C410.2, C411.2, C412.2, C413.2, C414.2, C415.2, C416.2, D400.3 (C), J400.3, J403.1, J404.1, J405.5 (GND), J405.S1 (GND), J405.S2 (GND), J405.S3 (GND), J405.S4 (GND), J406.5 (GND), J406.S1 (GND), J406.S2 (GND), J406.S3 (GND), J406.S4 (GND), J408.1, Q400.2 (S), Q401.2 (S), Q402.2 (S), Q403.2 (S), Q404.2 (S), Q405.2 (S), Q406.2 (S), R402.1, R403.1, RV400.1 (A), RV401.1 (A), SW400.2, SW401.2, SW402.2, SW403.2, SW404.2, SW405.2, SW406.2, SW407.2, SW409.1, U400.13 (VSS), U400.31 (AVSS), U400.36 (VSS), U400.45 (VSS), U400.52 (VUSB3V3), U400.53 (VSS), U400.63 (VSS), U400.75 (VSS), U400.84 (VSS), U400.92 (VSS), U401.5 (GND), U401.13 (GND), U403.8 (GND), U403.15 (!OE), U404.4 (V-), XDS400.1 (GND); also elsewhere on the board
I2S_LRCLK: A400.2 (RFS1), U400.79 (RD12); also elsewhere on the board
I2S_SCLK: A400.3 (SCLK1), U400.76 (RD1); also elsewhere on the board
I2S_SD: A400.4 (DT1), U400.77 (RD2); also elsewhere on the board
LCD_!CS: U400.7 (RC2), XDS400.7 (!CS)
LCD_!INT: U400.9 (RC4), XDS400.8 (!INT)
LCD_!PD: U400.8 (RC3), XDS400.9 (!PD)
LCD_ADD_PIN: U400.2 (RA5), XDS400.10 (AUDIO_L)
LCD_BL_CTL: Q400.1 (G), U400.1 (RG15)
LCD_GND_BL: Q400.3 (D), XDS400.16 (GND_BL), XDS400.18 (GND_BL)
LCD_GPIO0: U400.6 (RC1), XDS400.11 (GPIO0/IO2)
LCD_GPIO1: U400.5 (RE7), XDS400.12 (GPIO1/IO3)
LCD_GPIO2: U400.4 (RE6), XDS400.13 (GPIO2)
LCD_GPIO3: U400.3 (RE5), XDS400.14 (GPIO3)
LCD_MISO: U400.11 (RG7), XDS400.5 (MISO/IO1)
LCD_MOSI: U400.12 (RG8), XDS400.6 (MOSI/IO0)
LCD_SCK: U400.10 (RG6), XDS400.4 (SCK)
LCD_V0: RV401.2 (S), XDS400.3 (NC1)
LCD_VBL: SJ401.2, XDS400.15 (VBL), XDS400.17 (VBL)
LED_B: J401.4, Q403.3 (D)
LED_G: J401.2, Q401.3 (D)
LED_R: J401.3, Q402.3 (D)
MCU_!MCLR: J400.1, R401.2, TP400.TP, U400.15 (!MCLR)
MCU_!MCLR!_FILT: C400.1, R400.1, R401.1, SW409.2
MCU_AUX_DETECT: J408.4, U400.73 (RC14)
MCU_BACK_SW: SW403.1, U400.97 (RG13)
MCU_BAT_SENSE: R411.2, U404.5 (+IN)
MCU_BAT_SENSE_BUF: C404.1, TP408.TP, U400.26 (RB6), U404.6 (-IN), U404.7 (OUT)
MCU_BAT_SENSE_FB: R411.1, U402.1 (OUT), U402.2 (-IN)
MCU_BAT_VDIV: R404.1, R405.2, U402.3 (+IN)
MCU_CURR_SENSE: R412.1, U404.3 (+IN)
MCU_CURR_SENSE_+: R409.1, R410.2, U402.5 (+IN)
MCU_CURR_SENSE_-: R407.2, R408.1, U402.6 (-IN)
MCU_CURR_SENSE_BUF: C403.1, TP409.TP, U400.27 (RB7), U404.1 (OUT), U404.2 (-IN)
MCU_CURR_SENSE_FB: R407.1, R412.2, U402.7 (OUT)
MCU_FWD_SW: SW405.1, U400.99 (RE3)
MCU_LCD_BL_SW: SW406.1, U400.100 (RE4)
MCU_LED_B: Q403.1 (G), U400.20 (RB5)
MCU_LED_G: Q401.1 (G), U400.18 (RE8)
MCU_LED_MODE1: SW407.1 (O), U400.16 (RG9)
MCU_LED_MODE2: SW407.3 (S), U400.17 (RA0)
MCU_LED_POT: RV400.2 (S), U400.21 (RB4)
MCU_LED_R: Q402.1 (G), U400.19 (RE9)
MCU_MFB_SW: SW401.1, U400.95 (RG14)
MCU_OSC1: C405.2, U400.49 (RC12), Y400.2
MCU_OSC2: R406.2, U400.50 (RC15)
MCU_OSC2_R: C406.2, R406.1, Y400.1
MCU_PGC: J400.5, U400.24 (RB1)
MCU_PGD: J400.4, U400.25 (RB0)
MCU_PLAY_SW: SW404.1, U400.98 (RE2)
MCU_SWLED_MAIN: Q404.1 (G), U400.22 (RB3)
MCU_SWLED_PWR: Q405.1 (G), U400.23 (RB2)
MCU_UART_RX: U400.81 (RD4), U403.5 (B1)
MCU_UART_TX: U400.82 (RD5), U403.2 (B1)
MCU_VOL+_SW: SW402.1, U400.96 (RG12)
MCU_VOL-_SW: SW400.1, U400.94 (RE1)
SWLED_MAIN: J402.2, Q404.3 (D)
SWLED_PWR: J402.3, Q405.3 (D)
VBAT: R404.2; also elsewhere on the board
