BlockWorker/EE-BlockBox-v2/BlockBox v2.brd

## EAGLE design BlockBox v2.brd (continued)

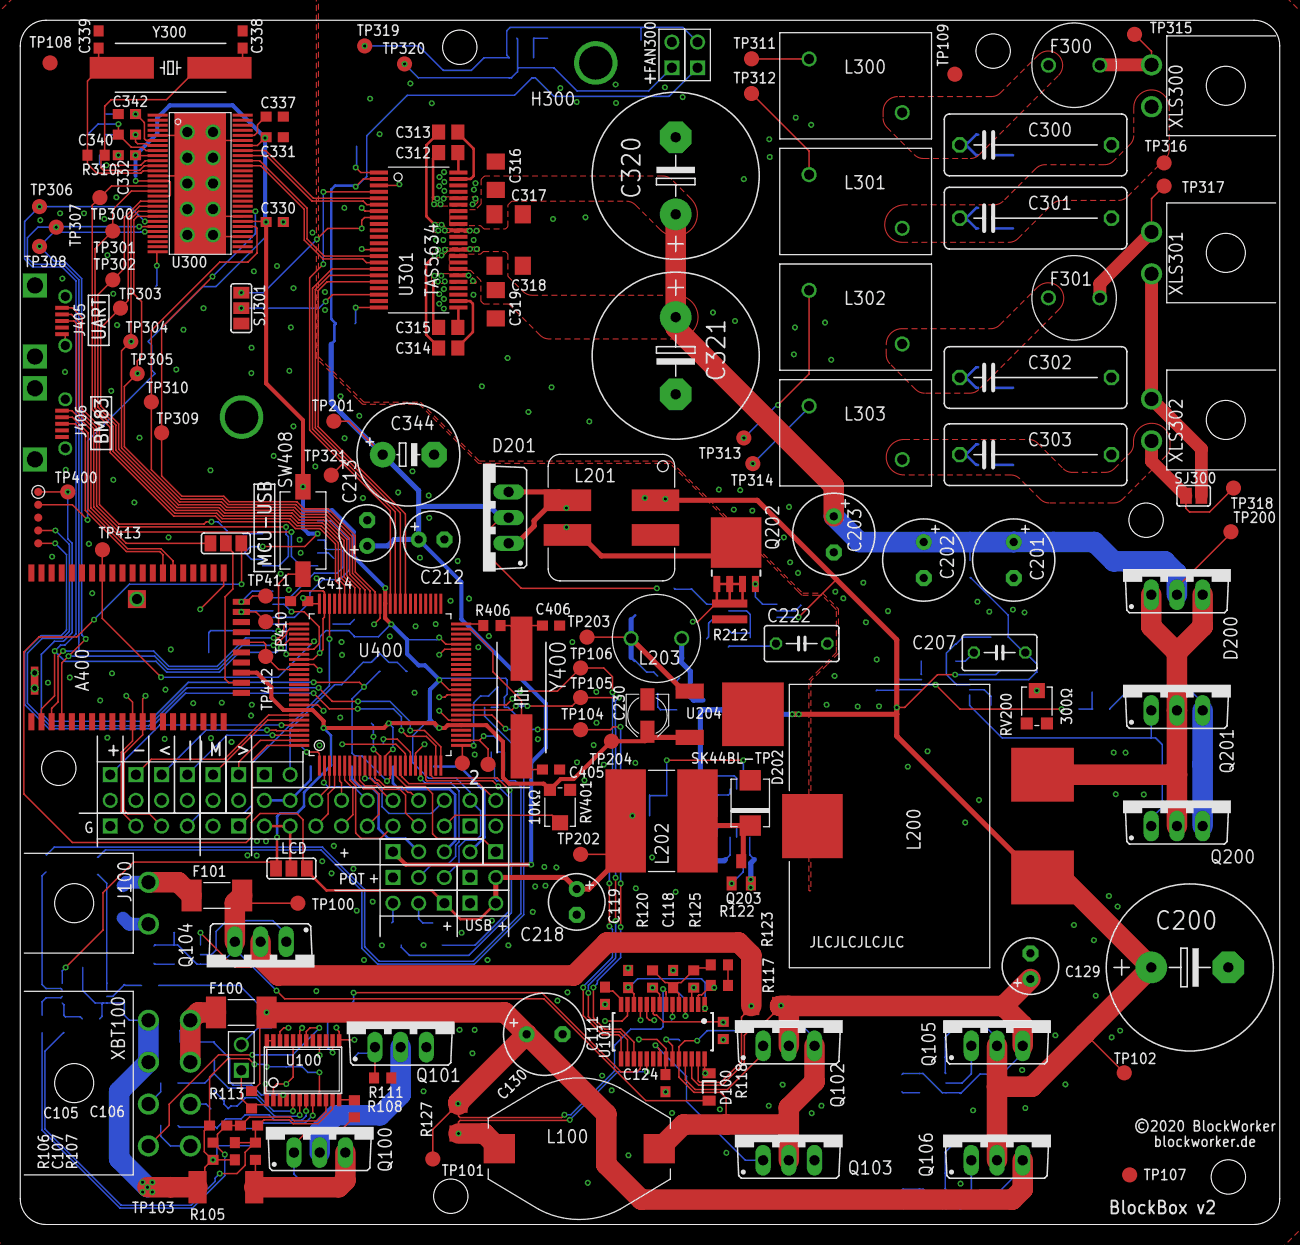
[picture p7: board BlockBox v2.brd from above]

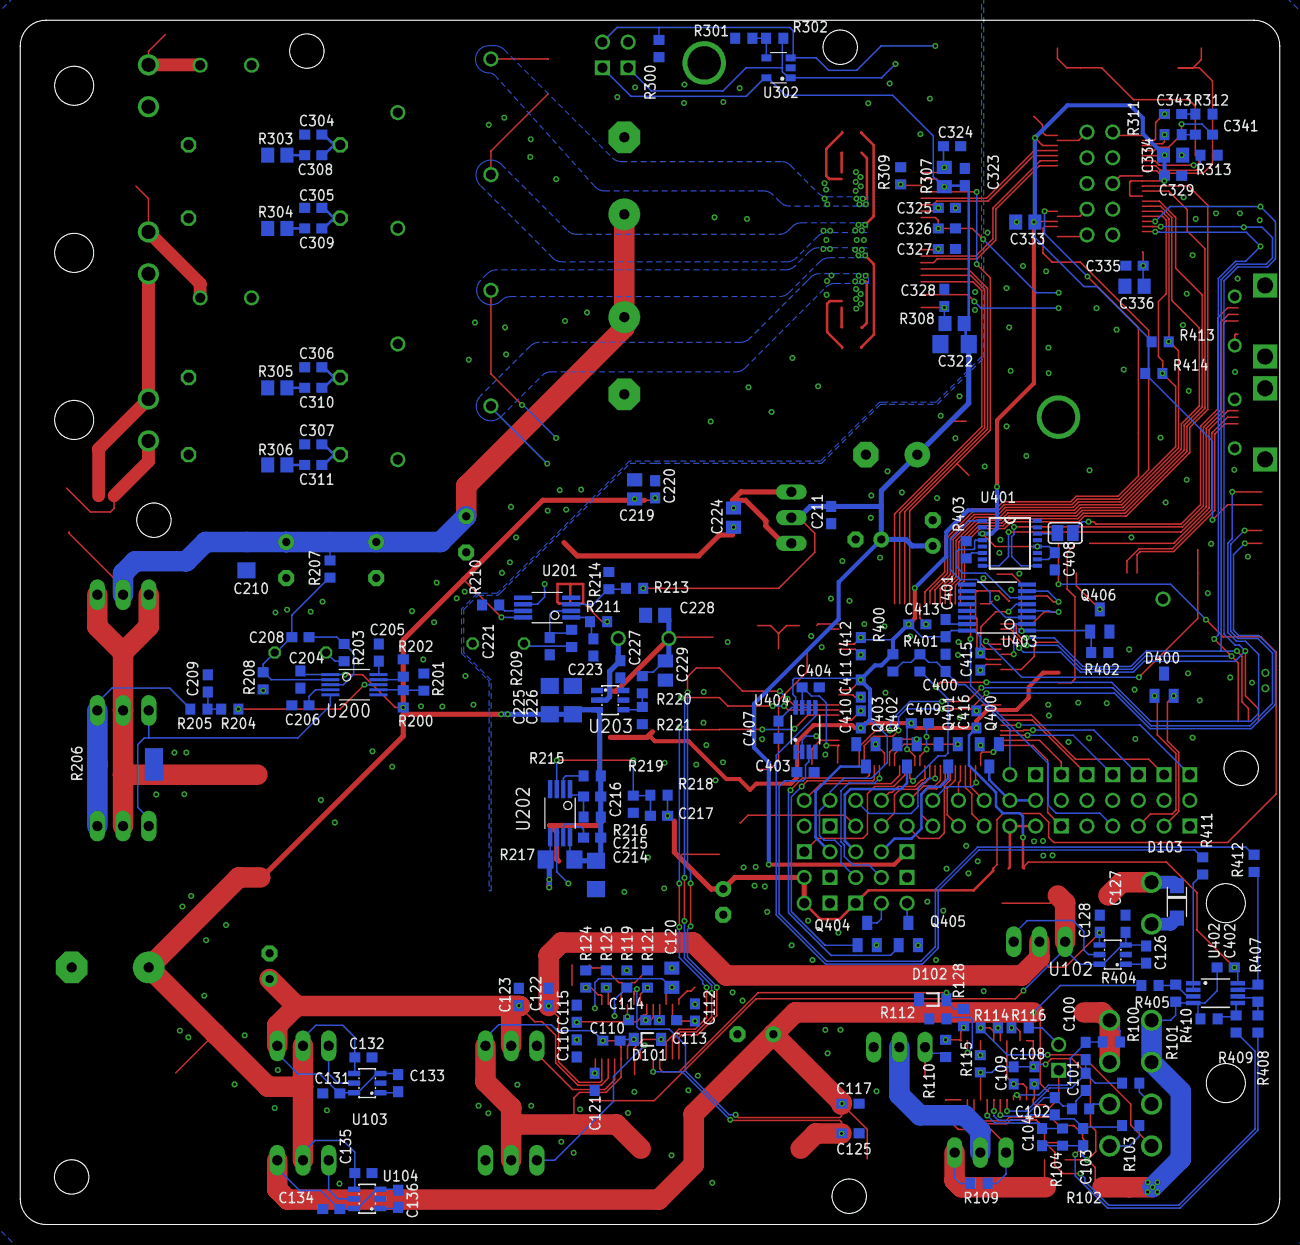
[picture p8: board BlockBox v2.brd from below]

Board: 2 copper layers, 124.5 x 119.0 mm, 350 parts (173 on the bottom side), 231 nets.
