BlockWorker/EE-BlockBox-v2/firmware/src/config/default/configuration.h

/*******************************************************************************
  System Configuration Header

  File Name:
    configuration.h

  Summary:
    Build-time configuration header for the system defined by this project.

  Description:
    An MPLAB Project may have multiple configurations.  This file defines the
    build-time options for a single configuration.

  Remarks:
    This configuration header must not define any prototypes or data
    definitions (or include any files that do).  It only provides macro
    definitions for build-time configuration options

*******************************************************************************/

// DOM-IGNORE-BEGIN
/*******************************************************************************
* Copyright (C) 2018 Microchip Technology Inc. and its subsidiaries.
*
* Subject to your compliance with these terms, you may use Microchip software
* and any derivatives exclusively with Microchip products. It is your
* responsibility to comply with third party license terms applicable to your
* use of third party software (including open source software) that may
* accompany Microchip software.
*
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
* IN NO EVENT WILL MICROCHIP BE LIABLE FOR ANY INDIRECT, SPECIAL, PUNITIVE,
* INCIDENTAL OR CONSEQUENTIAL LOSS, DAMAGE, COST OR EXPENSE OF ANY KIND
* WHATSOEVER RELATED TO THE SOFTWARE, HOWEVER CAUSED, EVEN IF MICROCHIP HAS
* BEEN ADVISED OF THE POSSIBILITY OR THE DAMAGES ARE FORESEEABLE. TO THE
* FULLEST EXTENT ALLOWED BY LAW, MICROCHIP'S TOTAL LIABILITY ON ALL CLAIMS IN
* ANY WAY RELATED TO THIS SOFTWARE WILL NOT EXCEED THE AMOUNT OF FEES, IF ANY,
* THAT YOU HAVE PAID DIRECTLY TO MICROCHIP FOR THIS SOFTWARE.
*******************************************************************************/
// DOM-IGNORE-END

#ifndef CONFIGURATION_H
#define CONFIGURATION_H

// *****************************************************************************
// *****************************************************************************
// Section: Included Files
// *****************************************************************************
// *****************************************************************************
/*  This section Includes other configuration headers necessary to completely
    define this configuration.
*/

#include "user.h"
#include "toolchain_specifics.h"

// DOM-IGNORE-BEGIN
#ifdef __cplusplus  // Provide C++ Compatibility

extern "C" {

#endif
// DOM-IGNORE-END

// *****************************************************************************
// *****************************************************************************
// Section: System Configuration
// *****************************************************************************
// *****************************************************************************



// *****************************************************************************
// *****************************************************************************
// Section: System Service Configuration
// *****************************************************************************
// *****************************************************************************
/* TIME System Service Configuration Options */
#define SYS_TIME_INDEX_0                     0
#define SYS_TIME_MAX_TIMERS                  200
#define SYS_TIME_HW_COUNTER_WIDTH            32
#define SYS_TIME_HW_COUNTER_PERIOD           4294967295U
#define SYS_TIME_HW_COUNTER_HALF_PERIOD	     (SYS_TIME_HW_COUNTER_PERIOD>>1)
#define SYS_TIME_CPU_CLOCK_FREQUENCY         198000000
#define SYS_TIME_COMPARE_UPDATE_EXECUTION_CYCLES      (620)


/* RX queue size has one additional element for the empty spot needed in circular queue */
#define SYS_CONSOLE_UART_RD_QUEUE_DEPTH_IDX0    11

/* TX queue size has one additional element for the empty spot needed in circular queue */
#define SYS_CONSOLE_UART_WR_QUEUE_DEPTH_IDX0    65
#define SYS_CONSOLE_BUFFER_DMA_READY


#define SYS_DEBUG_ENABLE
#define SYS_DEBUG_GLOBAL_ERROR_LEVEL       SYS_ERROR_DEBUG
#define SYS_DEBUG_PRINT_BUFFER_SIZE        200
#define SYS_DEBUG_BUFFER_DMA_READY
#define SYS_DEBUG_USE_CONSOLE


/* Console System Service Configuration Options */
#define SYS_CONSOLE_DEVICE_MAX_INSTANCES   1
#define SYS_CONSOLE_UART_MAX_INSTANCES     1



// *****************************************************************************
// *****************************************************************************
// Section: Driver Configuration
// *****************************************************************************
// *****************************************************************************
/* I2C Driver Instance 0 Configuration Options */
#define DRV_I2C_INDEX_0                       0
#define DRV_I2C_CLIENTS_NUMBER_IDX0           1
#define DRV_I2C_QUEUE_SIZE_IDX0               32
#define DRV_I2C_CLOCK_SPEED_IDX0              100000

/* I2C Driver Common Configuration Options */
#define DRV_I2C_INSTANCES_NUMBER              1


/* SPI Driver Common Configuration Options */
#define DRV_SPI_INSTANCES_NUMBER              1

/* SPI Driver Instance 0 Configuration Options */
#define DRV_SPI_INDEX_0                       0
#define DRV_SPI_CLIENTS_NUMBER_IDX0           1
#define DRV_SPI_QUEUE_SIZE_IDX0               64

/* USART Driver Instance 0 Configuration Options */
#define DRV_USART_INDEX_0                  0
#define DRV_USART_CLIENTS_NUMBER_IDX0      1
#define DRV_USART_QUEUE_SIZE_IDX0          25

/* USART Driver Global Configuration Options */
#define DRV_USART_INSTANCES_NUMBER         1


// *****************************************************************************
// *****************************************************************************
// Section: Middleware & Other Library Configuration
// *****************************************************************************
// *****************************************************************************


// *****************************************************************************
// *****************************************************************************
// Section: Application Configuration
// *****************************************************************************
// *****************************************************************************


//DOM-IGNORE-BEGIN
#ifdef __cplusplus
}
#endif
//DOM-IGNORE-END

#endif // CONFIGURATION_H
/*******************************************************************************
 End of File
*/
