BlockWorker/EE-BlockBox-v2/firmware/src/dap.c

/* ************************************************************************** */


/* ************************************************************************** */
/* ************************************************************************** */
/* Section: Included Files                                                    */
/* ************************************************************************** */
/* ************************************************************************** */

#include "dap.h"


/***************************/
/* Variables & Definitions */
/***************************/

#define DAP_I2C_ADDRESS 0x1a
#define I2C_TIMEOUT_MAX_DIFF 100000000 //difference (tick - timeoutTick) is compared to this, greater than this means not timed out (very high value means negative difference)
#define DAP_TASK_LIST_LENGTH 100

typedef struct {
    uint8_t* data;
    uint16_t dataLength;
    bool write;
    uint32_t delay;
    uint8_t errorCount;
    DAP_COMMAND_CALLBACK callback;
    uintptr_t callbackContext;
    //uint8_t index;
    bool free;
    bool sent;
    bool waiting;
    uint32_t timeoutTick;
    DRV_I2C_TRANSFER_HANDLE handle;
} DAP_COMMAND_TASK;

/*typedef struct dap_queueitem {
    DAP_COMMAND_TASK* task;
    struct dap_queueitem* next;
} DAP_QUEUE_ITEM;

typedef struct {
    DAP_QUEUE_ITEM* head;
    DAP_QUEUE_ITEM* tail;
    uint16_t length;
} DAP_COMMAND_QUEUE;*/

typedef struct {
    uintptr_t context1;
    uintptr_t context2;
    uintptr_t context3;
} EXTENDED_CONTEXT;

const uint8_t __attribute__((keep)) inputMixerCfg[] = //input mixer: 0.5 * A + 0.5 * B (stereo mixed into mono)
{ 0x00, 0x40, 0x00, 0x00, 0x00, 0x40, 0x00, 0x00,
  0x00, 0x00, 0x00, 0x00, 0x00, 0x00, 0x00, 0x00, 
  0x00, 0x00, 0x00, 0x00, 0x00, 0x00, 0x00, 0x00,
  0x00, 0x00, 0x00, 0x00, 0x00, 0x00, 0x00, 0x00 };

/*
const uint8_t __attribute__((keep)) eqHifi_treble[] = //hifi EQ coefficients for treble channel
{ 0x00, 0x74, 0xAE, 0xDF, 0xFF, 0x16, 0xA2, 0x42, 0x00, 0x74, 0xAE, 0xDF, 0x00, 0xE8, 0x5D, 0x19, 0xFF, 0x95, 0xA1, 0x9C,
  0x00, 0x58, 0x54, 0x58, 0xFF, 0xB8, 0x0A, 0x85, 0x00, 0x25, 0x03, 0xAA, 0x00, 0x19, 0xF9, 0xCF, 0xFF, 0xD4, 0xAC, 0x52,
  0x00, 0x81, 0x0D, 0xDA, 0xFF, 0x05, 0xAC, 0xF7, 0x00, 0x7C, 0x16, 0xA7, 0x00, 0xFA, 0x53, 0x09, 0xFF, 0x82, 0xDB, 0x80,
  0x00, 0x80, 0x84, 0x19, 0xFF, 0x07, 0x39, 0x09, 0x00, 0x7C, 0x3D, 0xC2, 0x00, 0xF8, 0xC6, 0xF7, 0xFF, 0x83, 0x3E, 0x25,
  0x00, 0x8E, 0x24, 0x9D, 0xFF, 0x3A, 0xFB, 0x76, 0x00, 0x44, 0x5D, 0xFF, 0x00, 0xC5, 0x04, 0x8A, 0xFF, 0xAD, 0x7D, 0x65,
  0x00, 0x85, 0x17, 0x80, 0xFF, 0x6A, 0x74, 0x03, 0x00, 0x55, 0xAC, 0xA0, 0x00, 0x95, 0x8B, 0xFD, 0xFF, 0xA5, 0x3B, 0xE0,
  0x00, 0x1C, 0x2F, 0x57, 0x00, 0x38, 0x5E, 0xAE, 0x00, 0x1C, 0x2F, 0x57, 0x00, 0x27, 0x5E, 0x56, 0xFF, 0xE7, 0xE4, 0x4E };

const uint8_t __attribute__((keep)) eqHifi_bass[] = //hifi EQ coefficients for bass channel
{ 0x00, 0x00, 0x80, 0x53, 0x00, 0x01, 0x00, 0xA6, 0x00, 0x00, 0x80, 0x53, 0x00, 0xE8, 0x5D, 0x19, 0xFF, 0x95, 0xA1, 0x9C,
  0x00, 0x44, 0xC7, 0x60, 0xFF, 0x76, 0xBB, 0x80, 0x00, 0x44, 0x7D, 0x48, 0x00, 0xFF, 0x9A, 0xBD, 0xFF, 0x80, 0x65, 0x1B,
  0x00, 0x80, 0xB8, 0x6C, 0xFF, 0x01, 0xCD, 0x4C, 0x00, 0x7D, 0x85, 0x9B, 0x00, 0xFE, 0x32, 0xB4, 0xFF, 0x81, 0xC1, 0xF9,
  0x00, 0x80, 0x04, 0x17, 0xFF, 0x00, 0x69, 0x5E, 0x00, 0x7F, 0x9A, 0x6A, 0x00, 0xFF, 0x96, 0xA2, 0xFF, 0x80, 0x61, 0x7E,
  0x00, 0x80, 0x0A, 0xA1, 0xFF, 0x01, 0x6B, 0x82, 0x00, 0x7E, 0xCC, 0x30, 0x00, 0xFE, 0x94, 0x7E, 0xFF, 0x81, 0x29, 0x30,
  0x00, 0x80, 0x72, 0x0D, 0xFF, 0x01, 0xD0, 0x20, 0x00, 0x7E, 0x1F, 0x1F, 0x00, 0xFE, 0x2F, 0xE0, 0xFF, 0x81, 0x6E, 0xD5,
  0x00, 0x81, 0xE7, 0x34, 0xFF, 0x07, 0x26, 0x72, 0x00, 0x78, 0x7D, 0x53, 0x00, 0xF8, 0xD9, 0x8E, 0xFF, 0x85, 0x9B, 0x79 };

const uint32_t __attribute__((keep)) eqHifi_treble_volume = 0x054; //-3dB
const uint32_t __attribute__((keep)) eqHifi_bass_volume = 0x048; //0dB

const uint8_t __attribute__((keep)) eqPower_treble[] = //power EQ coefficients for treble channel
{ 0x00, 0x74, 0xAE, 0xDF, 0xFF, 0x16, 0xA2, 0x42, 0x00, 0x74, 0xAE, 0xDF, 0x00, 0xE8, 0x5D, 0x19, 0xFF, 0x95, 0xA1, 0x9C,
  0x00, 0x2A, 0x59, 0xE7, 0x00, 0x54, 0xB3, 0xCE, 0x00, 0x2A, 0x59, 0xE7, 0x00, 0x0B, 0xDA, 0xDE, 0xFF, 0xCA, 0xBD, 0x86,
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
  0x00, 0x80, 0x00, 0x00, 0x00, 0x00, 0x00, 0x00, 0x00, 0x00, 0x00, 0x00, 0x00, 0x00, 0x00, 0x00, 0x00, 0x00, 0x00, 0x00,
  0x00, 0x80, 0x00, 0x00, 0x00, 0x00, 0x00, 0x00, 0x00, 0x00, 0x00, 0x00, 0x00, 0x00, 0x00, 0x00, 0x00, 0x00, 0x00, 0x00 };

const uint8_t __attribute__((keep)) eqCal_treble[] = //calibration EQ coefficients for treble channel
{ 0x00, 0x80, 0x00, 0x00, 0x00, 0x00, 0x00, 0x00, 0x00, 0x00, 0x00, 0x00, 0x00, 0x00, 0x00, 0x00, 0x00, 0x00, 0x00, 0x00,
  0x00, 0x80, 0x00, 0x00, 0x00, 0x00, 0x00, 0x00, 0x00, 0x00, 0x00, 0x00, 0x00, 0x00, 0x00, 0x00, 0x00, 0x00, 0x00, 0x00,
  0x00, 0x80, 0x00, 0x00, 0x00, 0x00, 0x00, 0x00, 0x00, 0x00, 0x00, 0x00, 0x00, 0x00, 0x00, 0x00, 0x00, 0x00, 0x00, 0x00,
  0x00, 0x80, 0x00, 0x00, 0x00, 0x00, 0x00, 0x00, 0x00, 0x00, 0x00, 0x00, 0x00, 0x00, 0x00, 0x00, 0x00, 0x00, 0x00, 0x00,
  0x00, 0x80, 0x00, 0x00, 0x00, 0x00, 0x00, 0x00, 0x00, 0x00, 0x00, 0x00, 0x00, 0x00, 0x00, 0x00, 0x00, 0x00, 0x00, 0x00,
  0x00, 0x80, 0x00, 0x00, 0x00, 0x00, 0x00, 0x00, 0x00, 0x00, 0x00, 0x00, 0x00, 0x00, 0x00, 0x00, 0x00, 0x00, 0x00, 0x00,
  0x00, 0x80, 0x00, 0x00, 0x00, 0x00, 0x00, 0x00, 0x00, 0x00, 0x00, 0x00, 0x00, 0x00, 0x00, 0x00, 0x00, 0x00, 0x00, 0x00 };

const uint32_t __attribute__((keep)) eqCal_treble_volume = 0x048; //0dB
const uint32_t __attribute__((keep)) eqCal_bass_volume = 0x048; //0dB

const uint8_t __attribute__((keep)) bassTrebleBypass[] = { 0x00, 0x00, 0x00, 0x00, 0x00, 0x80, 0x00, 0x00 }; //bass and treble set to inline mode

const uint8_t __attribute__((keep)) loudnessBiquad[] = //biquad for loudness compensation: 44Hz center, Q=0.4 Bandpass
{ 0x00, 0x00, 0x75, 0x88, 0x00, 0x00, 0x00, 0x00, 0xFF, 0xFF, 0x8A, 0x78, 0x00, 0xFF, 0x14, 0xAA, 0xFF, 0x80, 0xEB, 0x11 };
const uint32_t __attribute__((keep)) loudnessLG = 0xFFC00000; //log gain: -0.5 (==> 1/sqrt(V))
const uint32_t __attribute__((keep)) loudnessLO = 0x00000000; //log offset: 0

const uint32_t __attribute__((keep)) speakerPowerOffset = 0x010; //additional -4dB overall

const uint8_t __attribute__((keep)) energyManagerAvgConfig[] = //alpha = 4.17e-5, exponential average over last ~48k samples (.5s)
{ 0x00, 0x00, 0x01, 0x5E, 0x00, 0x7F, 0xFE, 0xA2, 0x00, 0x00, 0x01, 0x5E, 0x00, 0x7F, 0xFE, 0xA2 }; 
const uint32_t __attribute__((keep)) energyManagerWeight = 0x00800000; //weighting coefficient: 1
const uint32_t __attribute__((keep)) energyManagerSubThreshold = 0x00517CC2; //sub threshold: 0dB sine average (~ .637)
const uint32_t __attribute__((keep)) energyManagerSatThreshold = 0x0028D725; //sat threshold: -6dB sine average (~ .319)

const uint32_t __attribute__((keep)) thdManagerBoost = 0x07FFFFFF; //thd boost: +24.08dB (to engage clip at 0dB input)
const uint32_t __attribute__((keep)) thdManagerCut = 0x00050C33; //thd cut: -28.08dB (for -4dB output power offset)

static DRV_HANDLE dap_drv;

static uint32_t dap_sendTimeoutTicks; //how many ticks a transfer takes to time out
static uint32_t dap_sendPauseTicks; //how many ticks between transfers

static DAP_COMMAND_TASK dap_transferTasks[DAP_TASK_LIST_LENGTH];

bool dap_shutDown = true;
uint16_t dap_volume = 0x0c0;
bool dap_muted = true;
uint8_t dap_loudnessPercent = 0;
bool dap_overPower = false;

static bool dap_initInProgress = false;
static SUCCESS_CALLBACK dap_initSuccessCallback = NULL;

static uint32_t dap_sendNextAt;
static uint32_t dap_nextEnergyIntAt;
static uint32_t dap_energyIntPause;

/********************/
/* Helper functions */
/********************/

void dap_freeTask(DAP_COMMAND_TASK* task) {
    if (task == NULL) return;
    free(task->data);
    task->free = true;
}

DAP_COMMAND_TASK* dap_getFreeTask() {
    int i;
    for (i = 0; i < DAP_TASK_LIST_LENGTH; i++) {
        DAP_COMMAND_TASK* task = dap_transferTasks + i;
        if (task->free) return task;
    }
    return NULL;
}

void dap_clearTaskList() {
    int i;
    for (i = 0; i < DAP_TASK_LIST_LENGTH; i++) {
        DAP_COMMAND_TASK* task = dap_transferTasks + i;
        //task->index = i;
        task->free = true;
    }
}

/**********************/
/* Transfer functions */
/**********************/

//timer callback for command callback delay
void dap_callback_delay(uintptr_t context) {
    DAP_COMMAND_TASK* task = (DAP_COMMAND_TASK*)context;
    task->callback(true, task->data, task->dataLength, task->callbackContext);
    dap_freeTask(task);
}

//I2C transfer callback
void onI2CTransferEvent(DRV_I2C_TRANSFER_EVENT event, DRV_I2C_TRANSFER_HANDLE transferHandle, uintptr_t context) {
    if (event == DRV_I2C_TRANSFER_EVENT_PENDING) return; //ignore pending event
    
    DAP_COMMAND_TASK* task = NULL;
    int i;
    for (i = 0; i < DAP_TASK_LIST_LENGTH; i++) { //find corresponding task
        DAP_COMMAND_TASK* t = dap_transferTasks + i;
        if (!t->free && t->handle == transferHandle && t->sent) {
            task = t;
            break;
        }
    }
    if (task == NULL) return;
    
    if (event == DRV_I2C_TRANSFER_EVENT_COMPLETE) { //completed transfer: callback success
        if (task->callback) {
            if (task->delay > 0) { //if delay requested: set delay callback, otherwise callback immediately
                task->waiting = true;
                SYS_TIME_CallbackRegisterMS(dap_callback_delay, (uintptr_t)task, task->delay, SYS_TIME_SINGLE);
                return;
            } else task->callback(true, task->data, task->dataLength, task->callbackContext);
        }
    } else if (task->errorCount++ < 5) { //not completed: try again
        task->sent = false;
        return;
    } else if (task->callback) { //not completed: callback fail
        task->callback(false, task->data, task->dataLength, task->callbackContext);
    }
    
    dap_freeTask(task);
}

//write from buffer with callback
bool DAP_WriteBufferCallback(uint8_t subaddress, uint8_t* buffer, uint16_t length, DAP_COMMAND_CALLBACK callback, uintptr_t context, uint32_t callbackDelayMs) {
    DAP_COMMAND_TASK* task = dap_getFreeTask(); //get task object
    if (task == NULL) return false;
    
    task->free = false;
    task->dataLength = length + 1;
    task->data = malloc(task->dataLength); //allocate data array
    if (task->data == NULL) {
        dap_freeTask(task);
        return false;
    }
    task->write = true;
    task->delay = callbackDelayMs;
    task->callback = callback;
    task->callbackContext = context;
    task->errorCount = 0;
    task->sent = false;
    task->waiting = false;
    
    task->data[0] = subaddress;
    memcpy(task->data + 1, buffer, length); //copy data
    
    return true;
}

//write from buffer without callback
bool DAP_WriteBuffer(uint8_t subaddress, uint8_t* buffer, uint16_t length) {
    return DAP_WriteBufferCallback(subaddress, buffer, length, NULL, NULL, 0);
}

//write word with callback
bool DAP_WriteWordCallback(uint8_t subaddress, uint32_t value, DAP_COMMAND_CALLBACK callback, uintptr_t context, uint32_t callbackDelayMs) {
    uint8_t buffer[] = { value >> 24, (value >> 16) & 0xff, (value >> 8) & 0xff, value & 0xff };
    return DAP_WriteBufferCallback(subaddress, buffer, 4, callback, context, callbackDelayMs);
}

//write word without callback
bool DAP_WriteWord(uint8_t subaddress, uint32_t value) {
    return DAP_WriteWordCallback(subaddress, value, NULL, NULL, 0);
}

//write byte with callback
bool DAP_WriteByteCallback(uint8_t subaddress, uint8_t value, DAP_COMMAND_CALLBACK callback, uintptr_t context, uint32_t callbackDelayMs) {
    uint8_t buffer[] = { value };
    return DAP_WriteBufferCallback(subaddress, buffer, 1, callback, context, callbackDelayMs);
}

//write byte without callback
bool DAP_WriteByte(uint8_t subaddress, uint8_t value) {
    return DAP_WriteByteCallback(subaddress, value, NULL, NULL, 0);
}

//read data with callback
bool DAP_Read(uint8_t subaddress, uint16_t length, DAP_COMMAND_CALLBACK callback, uintptr_t context) {
    DAP_COMMAND_TASK* task = dap_getFreeTask(); //get task object
    if (task == NULL) return false;
    
    task->free = false;
    task->dataLength = length + 1;
    task->data = malloc(task->dataLength); //allocate data array
    if (task->data == NULL) {
        dap_freeTask(task);
        return false;
    }
    task->write = false;
    task->callback = callback;
    task->callbackContext = context;
    task->errorCount = 0;
    task->sent = false;
    task->waiting = false;
    
    task->data[0] = subaddress;
    
    return true;
}

void dap_energyCallback(bool success, uint8_t* buffer, uint16_t bufferLength, uintptr_t context) {
    switch(context) {
        case 0:
            if (success && (buffer[1] & 0x0a)) dap_overPower = true;
            DAP_WriteByteCallback(0x10, 0x00, dap_energyCallback, 1, 0);
            break;
        case 1:
            dap_nextEnergyIntAt = SYS_TIME_CounterGet() + dap_energyIntPause;
            break;
    }
}

void DAP_Tasks() {
    uint32_t tick = SYS_TIME_CounterGet();
    
    if (tick - dap_nextEnergyIntAt < I2C_TIMEOUT_MAX_DIFF) {
        if (!AMP_OTW_N_Get()) {
            dap_overPower = true;
            dap_nextEnergyIntAt = tick + dap_sendTimeoutTicks;
        } else if (DAP_EMO1_Get()) {
            DAP_Read(0x10, 1, dap_energyCallback, 0);
            dap_nextEnergyIntAt = tick + dap_sendTimeoutTicks;
        } else dap_nextEnergyIntAt = tick;
    }
    
    int i;
    for (i = 0; i < DAP_TASK_LIST_LENGTH; i++) {
        DAP_COMMAND_TASK* task = dap_transferTasks + i;
        if (task->free) continue;
        if (task->sent) {
            if (tick - task->timeoutTick < I2C_TIMEOUT_MAX_DIFF && !task->waiting) {
                task->sent = false;
                task->errorCount++;
            }
        } else if (tick - dap_sendNextAt < I2C_TIMEOUT_MAX_DIFF) {
        //} else {
            if (task->write) DRV_I2C_WriteTransferAdd(dap_drv, DAP_I2C_ADDRESS, task->data, task->dataLength, &task->handle); //write: simple write task
            else DRV_I2C_WriteReadTransferAdd(dap_drv, DAP_I2C_ADDRESS, task->data, 1, task->data + 1, task->dataLength - 1, &task->handle); //read: write subaddress, read data
            if (task->handle == DRV_I2C_TRANSFER_EVENT_HANDLE_INVALID) continue;
            task->sent = true;
            task->timeoutTick = tick + dap_sendTimeoutTicks;
            dap_sendNextAt = tick + dap_sendPauseTicks;
        }
    }
    if (tick - dap_sendNextAt < I2C_TIMEOUT_MAX_DIFF) dap_sendNextAt = tick;
}

/***********************/
/* Interface functions */
/***********************/

void dap_setVolumeCallback(bool success, uint8_t* buffer, uint16_t bufferLength, uintptr_t context) {
    if (success) {
        dap_volume = (buffer[3] << 8) | buffer[4];
    }
    if (context) ((SUCCESS_CALLBACK)context)(success);
}

bool DAP_SetVolume(uint16_t volume, SUCCESS_CALLBACK callback) {
    if (dap_shutDown) return false;
    if (dap_volume == volume) return false;
    return DAP_WriteWordCallback(0xd9, volume, dap_setVolumeCallback, (uintptr_t)callback, 70);
}

void dap_shutdown_timer_callback(uintptr_t context) {
    DAP_PDN_N_Clear();
    dap_shutDown = true;
    if (context) ((SUCCESS_CALLBACK)context)(true);
}

bool DAP_ShutDown(SUCCESS_CALLBACK callback) {
    if (dap_shutDown) return false;
    if (SYS_TIME_CallbackRegisterMS(dap_shutdown_timer_callback, (uintptr_t)callback, 70, SYS_TIME_SINGLE) != SYS_TIME_HANDLE_INVALID) {
        DAP_MUTE_N_Clear();
        return true;
    } else return false;
}

void dap_startup_timer_callback(uintptr_t context) {
    if (!dap_muted) DAP_MUTE_N_Set();
    dap_shutDown = false;
    if (context) ((SUCCESS_CALLBACK)context)(true);
}

bool DAP_StartUp(SUCCESS_CALLBACK callback) {
    if (!dap_shutDown) return false;
    if (SYS_TIME_CallbackRegisterMS(dap_startup_timer_callback, (uintptr_t)callback, 10, SYS_TIME_SINGLE) != SYS_TIME_HANDLE_INVALID) {
        DAP_PDN_N_Set();
        return true;
    } else return false;
}

void dap_mute_timer_callback(uintptr_t context) {
    dap_muted = true;
    if (context) ((SUCCESS_CALLBACK)context)(true);
}

bool DAP_Mute(SUCCESS_CALLBACK callback) {
    if (dap_shutDown) return false;
    if (dap_muted) return false;
    if (SYS_TIME_CallbackRegisterMS(dap_mute_timer_callback, (uintptr_t)callback, 70, SYS_TIME_SINGLE) != SYS_TIME_HANDLE_INVALID) {
        DAP_MUTE_N_Clear();
        return true;
    } else return false;
}

void dap_unmute_timer_callback(uintptr_t context) {
    dap_muted = false;
    if (context) ((SUCCESS_CALLBACK)context)(true);
}

bool DAP_Unmute(SUCCESS_CALLBACK callback) {
    if (dap_shutDown) return false;
    if (!dap_muted) return false;
    if (SYS_TIME_CallbackRegisterMS(dap_unmute_timer_callback, (uintptr_t)callback, 70, SYS_TIME_SINGLE) != SYS_TIME_HANDLE_INVALID) {
        DAP_MUTE_N_Set();
        return true;
    } else return false;
}

void dap_loudnessCallback2(bool success, uint8_t* buffer, uint16_t bufferLength, uintptr_t context) {
    EXTENDED_CONTEXT* econ = (EXTENDED_CONTEXT*)context;
    if (success) dap_loudnessPercent = (uint8_t)econ->context2;
    if (econ->context1) ((SUCCESS_CALLBACK)econ->context1)(success);
    free(econ);
}

void dap_loudnessCallback1(bool success, uint8_t* buffer, uint16_t bufferLength, uintptr_t context) {
    EXTENDED_CONTEXT* econ = (EXTENDED_CONTEXT*)context;
    if (success) {
        uint32_t gain = (buffer[1] << 24) | (buffer[2] << 16) | (buffer[3] << 8) | buffer[4];
        if (!DAP_WriteWordCallback(0x94, -gain, dap_loudnessCallback2, context, 0)) {
            if (econ->context1) {
                ((SUCCESS_CALLBACK)econ->context1)(false);
                free(econ);
            }
        }
    } else if (econ->context1) {
        ((SUCCESS_CALLBACK)econ->context1)(false);
        free(econ);
    }
}

bool DAP_SetLoudnessComp(uint8_t percent, SUCCESS_CALLBACK callback) {
    if (dap_shutDown) return false;
    if (dap_loudnessPercent == percent) return false;
    uint32_t squaredPercent = (uint32_t)percent * (uint32_t)percent / 100;
    uint32_t gain = (squaredPercent << 23) / 100;
    if (gain > 0x00800000) gain = 0x00800000;
    
    EXTENDED_CONTEXT* context = malloc(sizeof(EXTENDED_CONTEXT));
    context->context1 = (uintptr_t)callback;
    context->context2 = percent > 100 ? 100 : percent;
    
    return DAP_WriteWordCallback(0x93, gain, dap_loudnessCallback1, (uintptr_t)context, 0);
}

void dap_eqModeCallback(bool success, uint8_t* buffer, uint16_t bufferLength, uintptr_t context) {
    EXTENDED_CONTEXT* econ = (EXTENDED_CONTEXT*)context;
    if (success) {
        uint8_t* eq_bass = (uint8_t*)(econ->context2 ? eqPower_bass : eqHifi_bass);
        uint32_t eq_treble_vol = econ->context2 ? eqPower_treble_volume : eqHifi_treble_volume;
        uint32_t eq_bass_vol = econ->context2 ? eqPower_bass_volume : eqHifi_bass_volume;
        bool writeSuccess = true;
        switch (econ->context3) {
            case 0:
                econ->context3 = 1;
                writeSuccess = DAP_WriteBufferCallback(0x82, eq_bass, 140, dap_eqModeCallback, (uintptr_t)context, 0);
                break;
            case 1:
                econ->context3 = 2;
                writeSuccess = DAP_WriteWordCallback(0xd7, eq_treble_vol, dap_eqModeCallback, (uintptr_t)context, 0);
                break;
            case 2:
                econ->context3 = 3;
                writeSuccess = DAP_WriteWordCallback(0xd8, eq_bass_vol, dap_eqModeCallback, (uintptr_t)context, 0);
                break;
            case 3:
                dap_powerEQ = (bool)econ->context2;
                if (econ->context1) ((SUCCESS_CALLBACK)econ->context1)(true);
                free(econ);
                return;
        }
        if (!writeSuccess && econ->context1) {
            ((SUCCESS_CALLBACK)econ->context1)(false);
            free(econ);
        }
    } else if (econ->context1) {
        ((SUCCESS_CALLBACK)econ->context1)(false);
        free(econ);
    }
}

bool DAP_SetEQMode(bool power, SUCCESS_CALLBACK callback) {
    if (dap_shutDown) return false;
    if (dap_powerEQ == power) return false;
    
    EXTENDED_CONTEXT* context = malloc(sizeof(EXTENDED_CONTEXT));
    context->context1 = (uintptr_t)callback;
    context->context2 = power;
    context->context3 = 0;
    
    return DAP_WriteBufferCallback(0x7b, (uint8_t*)(power ? eqPower_treble : eqHifi_treble), 140, dap_eqModeCallback, (uintptr_t)context, 0);
}

void dap_trebleCallback(bool success, uint8_t* buffer, uint16_t bufferLength, uintptr_t context) {
    if (success) dap_treble = buffer[4];
    if (context) ((SUCCESS_CALLBACK)context)(success);
}

bool DAP_SetTreble(uint8_t value, SUCCESS_CALLBACK callback) {
    if (dap_shutDown) return false;
    if (dap_treble == value) return false;
    return DAP_WriteWordCallback(0xdd, 0x12121200 | value, dap_trebleCallback, (uintptr_t)callback, 0);
}

void dap_bassCallback(bool success, uint8_t* buffer, uint16_t bufferLength, uintptr_t context) {
    if (success) dap_bass = buffer[1];
    if (context) ((SUCCESS_CALLBACK)context)(success);
}

bool DAP_SetBass(uint8_t value, SUCCESS_CALLBACK callback) {
    if (dap_shutDown) return false;
    if (dap_bass == value) return false;
    return DAP_WriteWordCallback(0xdb, 0x00121212 | ((uint32_t)value << 24), dap_bassCallback, (uintptr_t)callback, 0);
}

void dap_calCallback(bool success, uint8_t* buffer, uint16_t bufferLength, uintptr_t context) {
    EXTENDED_CONTEXT* econ = (EXTENDED_CONTEXT*)context;
    if (success) {
        uint8_t* eq_treble = (uint8_t*)(econ->context2 > 0 ? eqCal_treble : dap_powerEQ ? eqPower_treble : eqHifi_treble);
        uint8_t* eq_bass = (uint8_t*)(econ->context2 > 0 ? eqCal_bass : dap_powerEQ ? eqPower_bass : eqHifi_bass);
        uint32_t eq_treble_vol = econ->context2 > 0 ? eqCal_treble_volume : dap_powerEQ ? eqPower_treble_volume : eqHifi_treble_volume;
        uint32_t eq_bass_vol = econ->context2 > 0 ? eqCal_bass_volume : dap_powerEQ ? eqPower_bass_volume : eqHifi_bass_volume;
        bool writeSuccess = true;
        switch (econ->context3) {
            case 0:
                econ->context3 = 1;
                writeSuccess = DAP_WriteBufferCallback(0x7b, eq_treble, 140, dap_calCallback, (uintptr_t)context, 0);
                break;
            case 1:
                econ->context3 = 2;
                writeSuccess = DAP_WriteBufferCallback(0x82, eq_bass, 140, dap_calCallback, (uintptr_t)context, 0);
                break;
            case 2:
                econ->context3 = 3;
                writeSuccess = DAP_WriteWordCallback(0xd7, eq_treble_vol, dap_calCallback, (uintptr_t)context, 0);
                break;
            case 3:
                econ->context3 = 4;
                writeSuccess = DAP_WriteWordCallback(0xd8, eq_bass_vol, dap_calCallback, (uintptr_t)context, 0);
                break;
            case 4:
                dap_cal_state = (uint8_t)econ->context2;
                if (econ->context1) ((SUCCESS_CALLBACK)econ->context1)(true);
                free(econ);
                return;
        }
        if (!writeSuccess && econ->context1) {
            ((SUCCESS_CALLBACK)econ->context1)(false);
            free(econ);
        }
    } else if (econ->context1) {
        ((SUCCESS_CALLBACK)econ->context1)(false);
        free(econ);
    }
}

bool DAP_SetCal(uint8_t state, SUCCESS_CALLBACK callback) {
    const uint8_t mutes[] = { 0x00, 0x40, 0x80, 0x00 };
    
    if (dap_shutDown) return false;
    if (dap_cal_state == state) return false;
    
    EXTENDED_CONTEXT* context = malloc(sizeof(EXTENDED_CONTEXT));
    context->context1 = (uintptr_t)callback;
    context->context2 = state;
    context->context3 = (state == 0 || dap_cal_state == 0) ? 0 : 4;
    
    return DAP_WriteByteCallback(0x0f, mutes[state], dap_calCallback, (uintptr_t)context, 0);
}

/****************************/
/* Initialization functions */
/****************************/

void DAP_IO_Init() {
    dap_drv = DRV_I2C_Open(DRV_I2C_INDEX_0, DRV_IO_INTENT_EXCLUSIVE);
    DRV_I2C_TransferEventHandlerSet(dap_drv, onI2CTransferEvent, 0);
    
    dap_sendTimeoutTicks = SYS_TIME_MSToCount(1000);
    dap_sendPauseTicks = SYS_TIME_MSToCount(50);
    dap_energyIntPause = SYS_TIME_MSToCount(200);
}

void dap_init_cmd_callback(bool success, uint8_t* buffer, uint16_t bufferLength, uintptr_t context) {
    if (!dap_initInProgress) return;
    
    if (!success) {
        dap_initInProgress = false;
        if (dap_initSuccessCallback != NULL) dap_initSuccessCallback(false);
    }
    
    bool sendSuccess = true;
    //context 0 means no further action
    switch (context) {
        case 0: return;
        case 1:
            sendSuccess = DAP_WriteByteCallback(0x14, 0x04, dap_init_cmd_callback, 2, 0); //input automute: -90dB threshold, 14.9ms delay
            break;
        case 2:
            sendSuccess = DAP_WriteByteCallback(0x19, 0x22, dap_init_cmd_callback, 3, 0); //modulation limit: 97.7% for channels 7, 8
            break;
        case 3:
            sendSuccess = DAP_WriteByteCallback(0x27, 0x3f, dap_init_cmd_callback, 4, 0); //keep channels 1-6 in shutdown
            break;
        case 4:
            sendSuccess = DAP_WriteBufferCallback(0x47, (uint8_t*)inputMixerCfg, 32, dap_init_cmd_callback, 5, 0); //channel 7 input mixer
            break;
        case 5:
            sendSuccess = DAP_WriteBufferCallback(0x48, (uint8_t*)inputMixerCfg, 32, dap_init_cmd_callback, 6, 0); //channel 8 input mixer
            break;
        case 6:
            sendSuccess = DAP_WriteBufferCallback(0x7b, (uint8_t*)eqHifi_treble, 140, dap_init_cmd_callback, 7, 0); //channel 7 biquad coefficients
            break;
        case 7:
            sendSuccess = DAP_WriteBufferCallback(0x82, (uint8_t*)eqHifi_bass, 140, dap_init_cmd_callback, 8, 0); //channel 8 biquad coefficients
            break;
        case 8:
            sendSuccess = DAP_WriteBufferCallback(0x8f, (uint8_t*)bassTrebleBypass, 8, dap_init_cmd_callback, 9, 0); //channel 7 bass/treble inline
            break;
        case 9:
            sendSuccess = DAP_WriteBufferCallback(0x90, (uint8_t*)bassTrebleBypass, 8, dap_init_cmd_callback, 10, 0); //channel 8 bass/treble inline
            break;
        case 10:
            sendSuccess = DAP_WriteWordCallback(0xd7, eqHifi_treble_volume, dap_init_cmd_callback, 11, 70); //channel 7 volume with power offset
            break;
        case 11:
            sendSuccess = DAP_WriteWordCallback(0xd8, eqHifi_bass_volume, dap_init_cmd_callback, 12, 70); //channel 8 volume with power offset
            break;
        case 12:
            sendSuccess = DAP_WriteBufferCallback(0x95, (uint8_t*)loudnessBiquad, 20, dap_init_cmd_callback, 13, 0); //loudness biquad
            break;
        case 13:
            sendSuccess = DAP_WriteWordCallback(0x91, loudnessLG, dap_init_cmd_callback, 14, 0); //loudness log gain
            break;
        case 14:
            sendSuccess = DAP_WriteWordCallback(0x92, loudnessLO, dap_init_cmd_callback, 15, 0); //loudness log offset
            break;
        case 15:
            sendSuccess = DAP_WriteWordCallback(0x93, 0, dap_init_cmd_callback, 16, 0); //loudness gain (initially off)
            break;
        case 16:
            sendSuccess = DAP_WriteWordCallback(0x94, 0, dap_init_cmd_callback, 17, 0); //loudness offset (initially 0)
            break;
        case 17:
            sendSuccess = DAP_WriteWordCallback(0xe9, thdManagerBoost, dap_init_cmd_callback, 18, 0); //THD manager boost
            break;
        case 18:
            sendSuccess = DAP_WriteWordCallback(0xea, thdManagerCut, dap_init_cmd_callback, 19, 0); //THD manager cut
            break;
        case 19:
            sendSuccess = DAP_WriteBufferCallback(0xb2, (uint8_t*)energyManagerAvgConfig, 16, dap_init_cmd_callback, 20, 0); //energy manager avg filter
            break;
        case 20:
            sendSuccess = DAP_WriteWordCallback(0xb9, energyManagerWeight, dap_init_cmd_callback, 21, 0); //energy manager sat weight
            break;
        case 21:
            sendSuccess = DAP_WriteWordCallback(0xba, energyManagerWeight, dap_init_cmd_callback, 22, 0); //energy manager sub weight
            break;
        case 22:
            sendSuccess = DAP_WriteWordCallback(0xbb, energyManagerSatThreshold, dap_init_cmd_callback, 23, 0); //energy manager sat threshold
            break;
        case 23:
            sendSuccess = DAP_WriteWordCallback(0xbd, energyManagerSubThreshold, dap_init_cmd_callback, 24, 0); //energy manager sub threshold
            break;
        case 24:
            sendSuccess = DAP_WriteByteCallback(0x10, 0x00, dap_init_cmd_callback, 25, 0); //energy manager flags reset
            break;
        case 25:
            sendSuccess = DAP_WriteWordCallback(0xd9, 0x0c0, dap_init_cmd_callback, 26, 70); //master volume (init to -30dB)
            break;
        case 26:
            sendSuccess = DAP_WriteByteCallback(0x03, 0x80, dap_init_cmd_callback, 27, 0); //syscon1: soft unmute from error, enable channels
            break;
        case 27: //init done
            dap_initInProgress = false;
            dap_shutDown = false;
            dap_muted = true;
            dap_volume = 0x0c0;
            dap_overPower = false;
            dap_powerEQ = false;
            dap_bass = 0x12;
            dap_treble = 0x12;
            if (dap_initSuccessCallback != NULL) dap_initSuccessCallback(true);
            return;
    }
    if (!sendSuccess) {
        dap_initInProgress = false;
        if (dap_initSuccessCallback != NULL) dap_initSuccessCallback(false);
    }
}

//timer callback for chip init
void dap_init_time_callback(uintptr_t context) {
    bool success;
    switch (context) {
        case 0: //reset low, wait 10ms
            DAP_PDN_N_Clear();
            DAP_RESET_N_Clear();
            SYS_TIME_CallbackRegisterMS(dap_init_time_callback, 1, 10, SYS_TIME_SINGLE);
            break;
        case 1: //reset up, wait 10ms
            DAP_RESET_N_Set();
            SYS_TIME_CallbackRegisterMS(dap_init_time_callback, 2, 10, SYS_TIME_SINGLE);
            break;
        case 2: //PDN high, wait 10ms
            DAP_PDN_N_Set();
            SYS_TIME_CallbackRegisterMS(dap_init_time_callback, 3, 10, SYS_TIME_SINGLE);
            break;
        case 3: //reset done: do first writes
            dap_shutDown = false;
            success = DAP_WriteByteCallback(0x04, 0x12, dap_init_cmd_callback, 1, 0); //syscon2: disable SDOUT and automute
            if (!success) {
                dap_initInProgress = false;
                if (dap_initSuccessCallback != NULL) dap_initSuccessCallback(false);
            }
            break;
    }
}

void DAP_Chip_Init(SUCCESS_CALLBACK callback) {
    dap_initInProgress = true;
    dap_initSuccessCallback = callback;
    
    dap_clearTaskList();
    uint32_t tick = SYS_TIME_CounterGet();
    dap_sendNextAt = tick;
    dap_nextEnergyIntAt = tick + dap_energyIntPause;
    
    DAP_MUTE_N_Clear(); //mute first, start reset after 100ms
    SYS_TIME_CallbackRegisterMS(dap_init_time_callback, 0, 1000, SYS_TIME_SINGLE);
}


/* *****************************************************************************
 End of File
 */
