BlockWorker/EE-BlockBox-v2/firmware/src/config/default/peripheral/gpio/plib_gpio.c

/*******************************************************************************
  SYS PORTS Static Functions for PORTS System Service

  Company:
    Microchip Technology Inc.

  File Name:
    plib_gpio.c

  Summary:
    GPIO function implementations for the GPIO PLIB.

  Description:
    The GPIO PLIB provides a simple interface to manage peripheral
    input-output controller.

*******************************************************************************/

//DOM-IGNORE-BEGIN
/*******************************************************************************
* Copyright (C) 2019 Microchip Technology Inc. and its subsidiaries.
*
* Subject to your compliance with these terms, you may use Microchip software
* and any derivatives exclusively with Microchip products. It is your
* responsibility to comply with third party license terms applicable to your
* use of third party software (including open source software) that may
* accompany Microchip software.
*
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
* IN NO EVENT WILL MICROCHIP BE LIABLE FOR ANY INDIRECT, SPECIAL, PUNITIVE,
* INCIDENTAL OR CONSEQUENTIAL LOSS, DAMAGE, COST OR EXPENSE OF ANY KIND
* WHATSOEVER RELATED TO THE SOFTWARE, HOWEVER CAUSED, EVEN IF MICROCHIP HAS
* BEEN ADVISED OF THE POSSIBILITY OR THE DAMAGES ARE FORESEEABLE. TO THE
* FULLEST EXTENT ALLOWED BY LAW, MICROCHIP'S TOTAL LIABILITY ON ALL CLAIMS IN
* ANY WAY RELATED TO THIS SOFTWARE WILL NOT EXCEED THE AMOUNT OF FEES, IF ANY,
* THAT YOU HAVE PAID DIRECTLY TO MICROCHIP FOR THIS SOFTWARE.
*******************************************************************************/
//DOM-IGNORE-END

#include "plib_gpio.h"


/* Array to store callback objects of each configured interrupt */
GPIO_PIN_CALLBACK_OBJ portPinCbObj[6];

/* Array to store number of interrupts in each PORT Channel + previous interrupt count */
uint8_t portNumCb[7 + 1] = { 0, 0, 0, 0, 0, 3, 3, 6, };

/******************************************************************************
  Function:
    GPIO_Initialize ( void )

  Summary:
    Initialize the GPIO library.

  Remarks:
    See plib_gpio.h for more details.
*/
void GPIO_Initialize ( void )
{
    /* PORTA Initialization */
    LATA = 0x0; /* Initial Latch Value */
    TRISACLR = 0x10; /* Direction Control */
    ANSELACLR = 0x21; /* Digital Mode Enable */
    CNPUASET = 0x1; /* Pull-Up Enable */
    CNPDASET = 0xe0; /* Pull-Down Enable */

    /* PORTB Initialization */
    ANSELBCLR = 0x72c; /* Digital Mode Enable */
    CNPUBSET = 0x700; /* Pull-Up Enable */

    /* PORTC Initialization */
    LATC = 0x4; /* Initial Latch Value */
    TRISCCLR = 0xc; /* Direction Control */
    ANSELCCLR = 0xd01e; /* Digital Mode Enable */
    CNPUCSET = 0x4010; /* Pull-Up Enable */
    CNPDCSET = 0x2000; /* Pull-Down Enable */

    /* PORTD Initialization */
    LATD = 0x200; /* Initial Latch Value */
    TRISDCLR = 0x2e00; /* Direction Control */
    CNPDDSET = 0x8; /* Pull-Down Enable */

    /* PORTE Initialization */
    ANSELECLR = 0x3f0; /* Digital Mode Enable */
    CNPUESET = 0x1e; /* Pull-Up Enable */
    CNPDESET = 0x1; /* Pull-Down Enable */
    /* Change Notice Enable */
    CNCONESET = _CNCONE_ON_MASK;
    PORTE;
    IEC3SET = _IEC3_CNEIE_MASK;

    /* PORTF Initialization */
    LATF = 0x20; /* Initial Latch Value */
    TRISFCLR = 0x21; /* Direction Control */
    ANSELFCLR = 0x1000; /* Digital Mode Enable */
    CNPDFSET = 0x6; /* Pull-Down Enable */

    /* PORTG Initialization */
    LATG = 0x8000; /* Initial Latch Value */
    TRISGCLR = 0x8000; /* Direction Control */
    ANSELGCLR = 0x83c0; /* Digital Mode Enable */
    CNPUGSET = 0x7200; /* Pull-Up Enable */
    CNPDGSET = 0x3; /* Pull-Down Enable */
    /* Change Notice Enable */
    CNCONGSET = _CNCONG_ON_MASK;
    PORTG;
    IEC3SET = _IEC3_CNGIE_MASK;


    /* Unlock system for PPS configuration */
    SYSKEY = 0x00000000;
    SYSKEY = 0xAA996655;
    SYSKEY = 0x556699AA;
    CFGCONbits.IOLOCK = 0;

    /* PPS Input Remapping */
    SDI1R = 0;
    SS1R = 10;
    SDI2R = 1;
    U2RXR = 4;
    U1RXR = 12;

    /* PPS Output Remapping */
    RPG8R = 6;
    RPD5R = 2;
    RPG0R = 1;
    RPE8R = 11;
    RPE9R = 11;
    RPB5R = 12;
    RPB3R = 12;
    RPB2R = 13;

    /* Lock back the system after PPS configuration */
    SYSKEY = 0x00000000;
    SYSKEY = 0xAA996655;
    SYSKEY = 0x556699AA;
    CFGCONbits.IOLOCK = 1;

    uint32_t i;
    /* Initialize Interrupt Pin data structures */
    portPinCbObj[0 + 0].pin = GPIO_PIN_RE1;
    
    portPinCbObj[3 + 0].pin = GPIO_PIN_RG14;
    
    portPinCbObj[3 + 1].pin = GPIO_PIN_RG12;
    
    portPinCbObj[3 + 2].pin = GPIO_PIN_RG13;
    
    portPinCbObj[0 + 1].pin = GPIO_PIN_RE2;
    
    portPinCbObj[0 + 2].pin = GPIO_PIN_RE3;
    
    for(i=0; i<6; i++)
    {
        portPinCbObj[i].callback = NULL;
    }
}

// *****************************************************************************
// *****************************************************************************
// Section: GPIO APIs which operates on multiple pins of a port
// *****************************************************************************
// *****************************************************************************

// *****************************************************************************
/* Function:
    uint32_t GPIO_PortRead ( GPIO_PORT port )

  Summary:
    Read all the I/O lines of the selected port.

  Description:
    This function reads the live data values on all the I/O lines of the
    selected port.  Bit values returned in each position indicate corresponding
    pin levels.
    1 = Pin is high.
    0 = Pin is low.

    This function reads the value regardless of pin configuration, whether it is
    set as as an input, driven by the GPIO Controller, or driven by a peripheral.

  Remarks:
    If the port has less than 32-bits, unimplemented pins will read as
    low (0).
    Implemented pins are Right aligned in the 32-bit return value.
*/
uint32_t GPIO_PortRead(GPIO_PORT port)
{
    return (*(volatile uint32_t *)(&PORTA + (port * 0x40)));
}

// *****************************************************************************
/* Function:
    void GPIO_PortWrite (GPIO_PORT port, uint32_t mask, uint32_t value);

  Summary:
    Write the value on the masked I/O lines of the selected port.

  Remarks:
    See plib_gpio.h for more details.
*/
void GPIO_PortWrite(GPIO_PORT port, uint32_t mask, uint32_t value)
{
    *(volatile uint32_t *)(&LATA + (port * 0x40)) = (*(volatile uint32_t *)(&LATA + (port * 0x40)) & (~mask)) | (mask & value);
}

// *****************************************************************************
/* Function:
    uint32_t GPIO_PortLatchRead ( GPIO_PORT port )

  Summary:
    Read the latched value on all the I/O lines of the selected port.

  Remarks:
    See plib_gpio.h for more details.
*/
uint32_t GPIO_PortLatchRead(GPIO_PORT port)
{
    return (*(volatile uint32_t *)(&LATA + (port * 0x40)));
}

// *****************************************************************************
/* Function:
    void GPIO_PortSet ( GPIO_PORT port, uint32_t mask )

  Summary:
    Set the selected IO pins of a port.

  Remarks:
    See plib_gpio.h for more details.
*/
void GPIO_PortSet(GPIO_PORT port, uint32_t mask)
{
    *(volatile uint32_t *)(&LATASET + (port * 0x40)) = mask;
}

// *****************************************************************************
/* Function:
    void GPIO_PortClear ( GPIO_PORT port, uint32_t mask )

  Summary:
    Clear the selected IO pins of a port.

  Remarks:
    See plib_gpio.h for more details.
*/
void GPIO_PortClear(GPIO_PORT port, uint32_t mask)
{
    *(volatile uint32_t *)(&LATACLR + (port * 0x40)) = mask;
}

// *****************************************************************************
/* Function:
    void GPIO_PortToggle ( GPIO_PORT port, uint32_t mask )

  Summary:
    Toggles the selected IO pins of a port.

  Remarks:
    See plib_gpio.h for more details.
*/
void GPIO_PortToggle(GPIO_PORT port, uint32_t mask)
{
    *(volatile uint32_t *)(&LATAINV + (port * 0x40))= mask;
}

// *****************************************************************************
/* Function:
    void GPIO_PortInputEnable ( GPIO_PORT port, uint32_t mask )

  Summary:
    Enables selected IO pins of a port as input.

  Remarks:
    See plib_gpio.h for more details.
*/
void GPIO_PortInputEnable(GPIO_PORT port, uint32_t mask)
{
    *(volatile uint32_t *)(&TRISASET + (port * 0x40)) = mask;
}

// *****************************************************************************
/* Function:
    void GPIO_PortOutputEnable ( GPIO_PORT port, uint32_t mask )

  Summary:
    Enables selected IO pins of a port as output(s).

  Remarks:
    See plib_gpio.h for more details.
*/
void GPIO_PortOutputEnable(GPIO_PORT port, uint32_t mask)
{
    *(volatile uint32_t *)(&TRISACLR + (port * 0x40)) = mask;
}

// *****************************************************************************
/* Function:
    void GPIO_PortInterruptEnable(GPIO_PORT port, uint32_t mask)

  Summary:
    Enables IO interrupt on selected IO pins of a port.

  Remarks:
    See plib_gpio.h for more details.
*/
void GPIO_PortInterruptEnable(GPIO_PORT port, uint32_t mask)
{
    *(volatile uint32_t *)(&CNENASET + (port * 0x40)) = mask;
}

// *****************************************************************************
/* Function:
    void GPIO_PortInterruptDisable(GPIO_PORT port, uint32_t mask)

  Summary:
    Disables IO interrupt on selected IO pins of a port.

  Remarks:
    See plib_gpio.h for more details.
*/
void GPIO_PortInterruptDisable(GPIO_PORT port, uint32_t mask)
{
    *(volatile uint32_t *)(&CNENACLR + (port * 0x40)) = mask;
}

// *****************************************************************************
// *****************************************************************************
// Section: GPIO APIs which operates on one pin at a time
// *****************************************************************************
// *****************************************************************************

// *****************************************************************************
/* Function:
    bool GPIO_PinInterruptCallbackRegister(
        GPIO_PIN pin,
        const GPIO_PIN_CALLBACK callback,
        uintptr_t context
    );

  Summary:
    Allows application to register callback for configured pin.

  Remarks:
    See plib_gpio.h for more details.
*/
bool GPIO_PinInterruptCallbackRegister(
    GPIO_PIN pin,
    const GPIO_PIN_CALLBACK callback,
    uintptr_t context
)
{
    uint8_t i;
    uint8_t portIndex;

    portIndex = pin >> 4;

    for(i = portNumCb[portIndex]; i < portNumCb[portIndex +1]; i++)
    {
        if (portPinCbObj[i].pin == pin)
        {
            portPinCbObj[i].callback = callback;
            portPinCbObj[i].context  = context;
            return true;
        }
    }
    return false;
}

// *****************************************************************************
// *****************************************************************************
// Section: Local Function Implementation
// *****************************************************************************
// *****************************************************************************


// *****************************************************************************
/* Function:
    void CHANGE_NOTICE_E_InterruptHandler()

  Summary:
    Interrupt Handler for change notice interrupt for channel E.

  Remarks:
	It is an internal function called from ISR, user should not call it directly.
*/
void CHANGE_NOTICE_E_InterruptHandler()
{
    uint8_t i;
    uint32_t status;

    status  = CNSTATE;
    status &= CNENE;

    PORTE;
    IFS3CLR = _IFS3_CNEIF_MASK;

    /* Check pending events and call callback if registered */
    for(i = 0; i < 3; i++)
    {
        if((status & (1 << (portPinCbObj[i].pin & 0xF))) && (portPinCbObj[i].callback != NULL))
        {
            portPinCbObj[i].callback (portPinCbObj[i].pin, portPinCbObj[i].context);
        }
    }
}

// *****************************************************************************
/* Function:
    void CHANGE_NOTICE_G_InterruptHandler()

  Summary:
    Interrupt Handler for change notice interrupt for channel G.

  Remarks:
	It is an internal function called from ISR, user should not call it directly.
*/
void CHANGE_NOTICE_G_InterruptHandler()
{
    uint8_t i;
    uint32_t status;

    status  = CNSTATG;
    status &= CNENG;

    PORTG;
    IFS3CLR = _IFS3_CNGIF_MASK;

    /* Check pending events and call callback if registered */
    for(i = 3; i < 6; i++)
    {
        if((status & (1 << (portPinCbObj[i].pin & 0xF))) && (portPinCbObj[i].callback != NULL))
        {
            portPinCbObj[i].callback (portPinCbObj[i].pin, portPinCbObj[i].context);
        }
    }
}


/*******************************************************************************
 End of File
*/
