BlockWorker/EE-BlockBox-v2/firmware/src/app.h

/*******************************************************************************
  MPLAB Harmony Application Header File

  Company:
    Microchip Technology Inc.

  File Name:
    app.h

  Summary:
    This header file provides prototypes and definitions for the application.

  Description:
    This header file provides function prototypes and data type definitions for
    the application.  Some of these are required by the system (such as the
    "APP_Initialize" and "APP_Tasks" prototypes) and some of them are only used
    internally by the application (such as the "APP_STATES" definition).  Both
    are defined here for convenience.
*******************************************************************************/

#ifndef _APP_H
#define _APP_H

// *****************************************************************************
// *****************************************************************************
// Section: Included Files
// *****************************************************************************
// *****************************************************************************

#include <stdint.h>
#include <stdbool.h>
#include <stddef.h>
#include <stdlib.h>
#include <string.h>
#include <stdio.h>
#include <math.h>
#include "configuration.h"
#include "definitions.h"

// DOM-IGNORE-BEGIN
#ifdef __cplusplus  // Provide C++ Compatibility

extern "C" {

#endif
// DOM-IGNORE-END

// *****************************************************************************
// *****************************************************************************
// Section: Type Definitions
// *****************************************************************************
// *****************************************************************************

// *****************************************************************************
/* Application states

  Summary:
    Application states enumeration

  Description:
    This enumeration defines the valid application states.  These states
    determine the behavior of the application at various times.
*/

typedef enum
{
    /* Application's state machine's initial state. */
    APP_STATE_INIT_UI=0,
    APP_STATE_INIT_DAP,
    APP_STATE_INIT_BM83,
    APP_STATE_SERVICE_TASKS,
    /* TODO: Define states used by the application state machine. */

} APP_STATES;


typedef void (*SUCCESS_CALLBACK)(bool success);

// *****************************************************************************
/* Application Data

  Summary:
    Holds application data

  Description:
    This structure holds the application's data.

  Remarks:
    Application strings and buffers are be defined outside this structure.
 */

typedef struct
{
    /* The application's current state */
    APP_STATES state;

    /* TODO: Define any additional data used by the application. */

} APP_DATA;

bool amp_enabled;

uint16_t batteryVoltageCountAverage;
uint16_t batteryCurrentCountAverage;
double batteryVolts;
uint8_t batteryPercent;
double batteryAmps;
double batteryEnergy;
bool batteryDataValid;
bool batteryUpdated;

void batVoltageADCCallback();
void batCurrentADCCallback();

void APP_Initialize();

void APP_Tasks();

#endif /* _APP_H */

//DOM-IGNORE-BEGIN
#ifdef __cplusplus
}
#endif
//DOM-IGNORE-END

/*******************************************************************************
 End of File
 */
