BlockWorker/EE-BlockBox-v2/firmware/src/config/default/interrupts.c

/*******************************************************************************
 System Interrupts File

  Company:
    Microchip Technology Inc.

  File Name:
    interrupt.c

  Summary:
    Interrupt vectors mapping

  Description:
    This file maps all the interrupt vectors to their corresponding
    implementations. If a particular module interrupt is used, then its ISR
    definition can be found in corresponding PLIB source file. If a module
    interrupt is not used, then its ISR implementation is mapped to dummy
    handler.
 *******************************************************************************/

// DOM-IGNORE-BEGIN
/*******************************************************************************
* Copyright (C) 2018 Microchip Technology Inc. and its subsidiaries.
*
* Subject to your compliance with these terms, you may use Microchip software
* and any derivatives exclusively with Microchip products. It is your
* responsibility to comply with third party license terms applicable to your
* use of third party software (including open source software) that may
* accompany Microchip software.
*
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
* IN NO EVENT WILL MICROCHIP BE LIABLE FOR ANY INDIRECT, SPECIAL, PUNITIVE,
* INCIDENTAL OR CONSEQUENTIAL LOSS, DAMAGE, COST OR EXPENSE OF ANY KIND
* WHATSOEVER RELATED TO THE SOFTWARE, HOWEVER CAUSED, EVEN IF MICROCHIP HAS
* BEEN ADVISED OF THE POSSIBILITY OR THE DAMAGES ARE FORESEEABLE. TO THE
* FULLEST EXTENT ALLOWED BY LAW, MICROCHIP'S TOTAL LIABILITY ON ALL CLAIMS IN
* ANY WAY RELATED TO THIS SOFTWARE WILL NOT EXCEED THE AMOUNT OF FEES, IF ANY,
* THAT YOU HAVE PAID DIRECTLY TO MICROCHIP FOR THIS SOFTWARE.
 *******************************************************************************/
// DOM-IGNORE-END

// *****************************************************************************
// *****************************************************************************
// Section: Included Files
// *****************************************************************************
// *****************************************************************************

#include "configuration.h"
#include "definitions.h"
#include "ui.h"
#include "bm83.h"

// *****************************************************************************
// *****************************************************************************
// Section: System Interrupt Vector Functions
// *****************************************************************************
// *****************************************************************************


void CORE_TIMER_InterruptHandler( void );
void TIMER_2_InterruptHandler( void );
void UART1_FAULT_InterruptHandler( void );
void UART1_RX_InterruptHandler( void );
void UART1_TX_InterruptHandler( void );
void I2C1_BUS_InterruptHandler( void );
void I2C1_MASTER_InterruptHandler( void );
void CHANGE_NOTICE_E_InterruptHandler( void );
void CHANGE_NOTICE_G_InterruptHandler( void );
void DMA0_InterruptHandler( void );
void SPI2_RX_InterruptHandler( void );
void SPI2_TX_InterruptHandler( void );
void UART2_FAULT_InterruptHandler( void );
void UART2_RX_InterruptHandler( void );
void UART2_TX_InterruptHandler( void );
void NVM_InterruptHandler( void );



/* All the handlers are defined here.  Each will call its PLIB-specific function. */
void __ISR(_CORE_TIMER_VECTOR, ipl1AUTO) CORE_TIMER_Handler (void)
{
    CORE_TIMER_InterruptHandler();
}

void __ISR(_TIMER_2_VECTOR, ipl1AUTO) TIMER_2_Handler (void)
{
    TIMER_2_InterruptHandler();
}

/*void __ISR(_EXTERNAL_4_VECTOR, ipl1AUTO) EXTERNAL_4_Handler (void)
{
    #ifdef UI_TOUCH
    UI_InterruptHandler();
    #endif
    SYS_INT_SourceStatusClear(INT_SOURCE_EXTERNAL_4);
}*/

void __ISR(_ADC_DF1_VECTOR, ipl1AUTO) ADC_DF1_Handler (void)
{
    batVoltageADCCallback();
    SYS_INT_SourceStatusClear(INT_SOURCE_ADC_DF1);
}

void __ISR(_ADC_DF2_VECTOR, ipl1AUTO) ADC_DF2_Handler (void)
{
    batCurrentADCCallback();
    SYS_INT_SourceStatusClear(INT_SOURCE_ADC_DF2);
}

void __ISR(_ADC_DF3_VECTOR, ipl1AUTO) ADC_DF3_Handler (void)
{
    SYS_INT_SourceStatusClear(INT_SOURCE_ADC_DF3);
}

void __ISR(_UART1_FAULT_VECTOR, ipl1AUTO) UART1_FAULT_Handler (void)
{
    UART1_FAULT_InterruptHandler();
}

void __ISR(_UART1_RX_VECTOR, ipl1AUTO) UART1_RX_Handler (void)
{
    UART1_RX_InterruptHandler();
}

void __ISR(_UART1_TX_VECTOR, ipl1AUTO) UART1_TX_Handler (void)
{
    UART1_TX_InterruptHandler();
}

void __ISR(_I2C1_BUS_VECTOR, ipl1AUTO) I2C1_BUS_Handler (void)
{
    I2C1_BUS_InterruptHandler();
}

void __ISR(_I2C1_MASTER_VECTOR, ipl1AUTO) I2C1_MASTER_Handler (void)
{
    I2C1_MASTER_InterruptHandler();
}

void __ISR(_CHANGE_NOTICE_E_VECTOR, ipl1AUTO) CHANGE_NOTICE_E_Handler (void)
{
    CHANGE_NOTICE_E_InterruptHandler();
}

void __ISR(_CHANGE_NOTICE_G_VECTOR, ipl1AUTO) CHANGE_NOTICE_G_Handler (void)
{
    CHANGE_NOTICE_G_InterruptHandler();
}

void __ISR(_DMA0_VECTOR, ipl1AUTO) DMA0_Handler (void)
{
    DMA0_InterruptHandler();
}

void __ISR(_SPI2_RX_VECTOR, ipl1AUTO) SPI2_RX_Handler (void)
{
    SPI2_RX_InterruptHandler();
}

void __ISR(_SPI2_TX_VECTOR, ipl1AUTO) SPI2_TX_Handler (void)
{
    SPI2_TX_InterruptHandler();
}

void __ISR(_UART2_FAULT_VECTOR, ipl1AUTO) UART2_FAULT_Handler (void)
{
    UART2_FAULT_InterruptHandler();
}

void __ISR(_UART2_RX_VECTOR, ipl1AUTO) UART2_RX_Handler (void)
{
    //BM83_UART_DMAReplacement();
    //UART2_RX_InterruptHandler();
}

void __ISR(_UART2_TX_VECTOR, ipl1AUTO) UART2_TX_Handler (void)
{
    UART2_TX_InterruptHandler();
}

void __ISR(_FLASH_CONTROL_VECTOR, ipl1AUTO) FLASH_CONTROL_Handler (void)
{
    NVM_InterruptHandler();
}




/*******************************************************************************
 End of File
*/
