BlockWorker/EE-BlockBox-v2/(commit log)

2020-01-08 Initial Commit.
    [BlockBox v2.sch]
2020-01-14 Audio path done, MCU project added
    [BlockBox v2.sch]
2020-01-18 MCU config done (for now), schematic base done
    [BlockBox v2.sch, configuration.h]
2020-01-18 Testpads added, schematic done (barring oversights)
    [BlockBox v2.sch]
2020-01-19 Some oversights fixed, minor additions.
    [BlockBox v2.sch]
2020-01-21 Test pads named, board started
    [BlockBox v2.brd, BlockBox v2.sch]
2020-01-26 Major PCB progress, about to shrink PCB (safety commit)
    [BlockBox v2.brd, BlockBox v2.sch]
2020-01-28 Voltage converter layout done
    [BlockBox v2.brd]
2020-02-05 PCB initially completed, final fixes
    [BlockBox v2.brd, BlockBox v2.sch]
2020-02-05 Added logo and ground TPs
    [BlockBox v2.brd, BlockBox v2.sch]
2020-02-06 Final PCB order adjustments
    [BlockBox v2.brd]
2020-02-26 Added laser cut and Fusion 360 data.
    [Main v23.f3z]
2020-03-02 Firmware progress, speaker EQ start: woofer response
    [configuration.h]
2020-03-06 Added speaker EQs for old speaker setup (v1) and power EQ for new setup
2020-03-15 Minor BM83 config changes, firmware progress (I2S + BM83 comms)
    [configuration.h]
2020-03-17 Finished BM83 UART protocol (?), updated gitignore
2020-03-26 Fixed ridiculous labeling mistake.
    [BlockBox v2.brd]
2020-03-28 UART protocol finished, added debug UART port
    [configuration.h]
2020-04-18 Major firmware progress, added CAM data
    [configuration.h]
2020-06-01 Screen progress, CAD done(?)
2020-06-10 Major UI progress, started backing away from dynamic allocation
    [configuration.h]
2020-06-11 Implemented battery energy estimation, made FT8 driver semi-static
    [configuration.h]
2020-06-11 Fixed idiotic and expensive laser cut template mistake.
2020-07-15 Basic functionality established, lights implemented
    [configuration.h]
2021-08-09 Display somehow not working again, safety commit before rework
    [FT8_commands.c, dap.c, dap.h, plib_spi2.c, ui_touch.c]
2021-08-22 Implemented missing features, reworked EQs based on measurement
    [FT8_commands.c, app.c, app.h, dap.c, dap.h, plib_spi2.c, ui_touch.c]
