BlockWorker/EE-BlockBox-v2/(notices)

Notices in the files:
BlockBox v2.brd:
©2020 BlockWorker
